TobiasRosini/cnc_plasmacutter/README.md

# CNC-Plasmacutter

Kompakter, rollbarer CNC-Plasmaschneidtisch für die Werkstatt.

- Verfahrbereich Düse: 1100 × 550 mm (Y lang, beidseitig angetriebenes Portal; X kurz)
- Plasmagerät: SPARTUS XPro CUT 70CNC
- Steuerung: LinuxCNC mit QtPlasmaC, Mesa 7i96S
- CAD: FreeCAD

## Struktur

| Ordner | Inhalt |
|---|---|
| `docs/` | Projektstand, Notizen, Datenblätter |
| `cad/` | FreeCAD-Modelle |
| `linuxcnc/` | LinuxCNC-/QtPlasmaC-Konfiguration |
| `elektrik/` | Schaltpläne und Verdrahtung |

Aktueller Stand: [docs/CNC_Plasmatisch_Projektstand_vision_2026-10-19.md](docs/CNC_Plasmatisch_Projektstand_vision_2026-10-19.md)
