TobiasRosini/cnc_plasmacutter/cad/energiekette/README.md

# Energieketten

Beide Ketten: **igus E2/000 Serie 2400.03** (innen 38 × 25, außen 54 × 35, Teilung 46 mm/Glied, im Innenradius aufklappbar), Anschlussteile **igus 2030.12PZ** (Kunststoff, verriegelt, Satz für beide Enden): Platte 7 mm, 55 breit, 40 lang, je 2 Bohrungen Ø6,1 im Abstand 25 quer zur Kette, 10 mm vom äußeren Ende; befestigt mit M5. Radius R bis Kettenmitte (igus: Bauhöhe H = 2R + 35). Länge nach igus S/2 + K (Katalog 5.102).

| | Artikel | Glieder | Länge |
|---|---|---|---|
| Y-Kette | 2400.03.125.0 | 23 | 1058 mm (igus-Formel 1056) |
| X-Kette | 2400.03.075.0 | 14 | 644 mm (igus-Formel 629) |
| Anschlussteile | 2030.12PZ.A1 (vormontiert, Einbaulage A1) | 2 Sätze | |
| Trennstege | 211, jedes 2. Glied | Y 11, X 7 | |

Belegung und Leitungen: `docs/Kabelliste.md`.

## Y-Energiekette (rechts, liegend)

```
python3 cad/live.py cad/energiekette/energiekette.py
```

- R125, 23 Glieder, Festpunkt bei Rahmen-y 825 (105 mm vor der Mitte des Y-Wegs, so dass die längere igus-Kette hinten nicht weiter übersteht), **Schlaufe hinten**, die Kabel verlassen den Festpunkt nach vorn (Schaltschrank und Plasmagerät stehen vorn). Seit die X-Ablage über der Brücke liegt, reicht die Schlaufe nur noch knapp 10 mm hinter den Rahmen.
- Träger Stahl 40 × 20 × 2 flach von hinten bis y 1437 (endet vorn im Kanalknoten), Unterkante 163 mm über Rahmen-OK (über dem X-Schalterblock), darauf hinten eine Rinne aus Alu-U-Profil 20 × 60 × 20 × 2 (Handel, z. B. alu-verkauf.de; innen 56, Kette 54) bis hinter das feste Kettenende, davor ein Kabelkanal 40 × 40 bis y 1437. Träger und Kanal stecken vorn gemeinsam im gedruckten **Kanalknoten** (`cad/unterbau/README.md`), der Träger dort mit 2× M5 von innen in Nietmuttern. Zwei Stützen außen am Längsträger: hinten am Rahmenende ein Rohr 20 × 40 × 2 (2× M6 in Nietmuttern) mit Druckkopf unter dem Träger (kopfüber druckbar, M5-Muttern in Schlitzen); vorn direkt hinter dem vorderen Bein ein Rohr 40 × 40 × 2 (y 1436–1476, 4× M6 in Nietmuttern in Längsträger und Längsrohr des Untertischs) von Rahmen-z 680 bis 900, darauf der Kanalknoten (2× M5 von vorn in Nietmuttern). Außen an der vorderen Stütze ist der senkrechte Kabelkanal befestigt (4× M5 in Nietmuttern).
- Kettenturm aus Alu-Flachmaterial 40 × 8 an der Stirn der rechts um 48,5 mm verlängerten Brücke (Stirn liegt am Turm an): 4× M6 in Muttern eines Einsteckteils (Druck, Muttern seitlich eingeschoben), das in der Brücke steckt und von den beiden M6 des Sattels mit gehalten wird. Ohne Laschen: Druckteile mit eingepressten M5-Muttern sitzen innen am Turm (Halter Y oben, Ablagehalter X unten).
- Kette innen 7 mm außerhalb der Schienenmitte: Der Z-Schlitten fährt bei X ganz rechts bis knapp davor. Der Z-Kopf ist rechts schmaler (52 statt 58 mm).
- Gesamtbreite mit Kette: 781 mm.
- Im Zusammenbau wird die Kette für die jeweilige Portallage neu berechnet.

## X-Energiekette

Seiten von vorn gesehen (vorn = +Y): die Y-Kette liegt rechts (kleines x).

- R75 (R65 gibt es bei igus nicht; die Adern liegen innen in der Kehre damit noch über R60), 14 Glieder, liegend auf einer Ablage (Alu 40 × 20 × 2 + Rinne aus demselben U-Profil 20 × 60 × 20 × 2 wie in Y) über der Brücke, direkt hinter dem Z-Kopf, Unterkante 225 mm über Rahmen-OK, oben bis 432.
- **Festpunkt bei Rahmen-x 476** (2× M5 durch den Rinnenboden: vorn in eine Nietmutter der Ablage, hinten in eine seitlich eingeschobene Mutter im dritten Rinnenhalter, weil die Rinne dort hinten über die Ablage übersteht), **Schlaufe nach rechts** zum Kettenturm. Der Festpunkt liegt so weit rechts, wie es die Kette mit igus-Länge zulässt: Bei X ganz rechts beginnt der Bogen direkt am Anschlussteil, die Schlaufe bleibt 4 mm vor dem Turm. Steht der Wagen links, trägt sich das obere Trum etwa 160 mm frei über den Festpunkt hinaus (igus: freitragend bis etwa 2 m). Bewegtes Ende am Halter (Druck) an der Rückseite des Z-Kopf-Sockels (2× M5 in Muttern), 10 mm rechts der Wagenmitte. Die Leitungen treten dort nach links aus.
- Warum nicht ganz links: kürzere Kette und kürzerer Rücklauf der Leitungen in der Ablage hinten (vorher Festpunkt links, 0,80 m Kette, 1,42 m Leitung bis zum Festpunkt). Ganz in die Mitte geht mit der igus-Länge nicht, dann stieße die Schlaufe an den Turm.
- Warum Schlaufe rechts: Die Adern müssen am bewegten Ende zum Brenner umkehren (Kehre R60, etwa 70 mm). Rechts stehen bei X am Ende Kettenturm und Y-Kettenende; links ist der Platz frei. Bei X ganz links reichen die Adern 4 mm über die Brückenstirn (Rahmen-x 724, oberhalb der Platte, innerhalb der Gesamtbreite).
- Ablage (y −20…20) bündig mit Turm und Platte (Brückentiefe), oben bündig mit der Platte. Die Rinne darauf ist auf die Kette ausgerichtet (Kettenvorderkante y 13,5) und steht hinten 23,5 mm über, vorn 3,5 mm hinter der Ablage. Ablage und Rinne reichen rechts bis an den Ablagehalter (Druck, Platte 15 mm innen am Turm, 2× M5 durch den Turm) und stecken auf dessen Zapfen (25 mm, 2× M5 von unten); bei X ganz rechts liegt die Schlaufe auf Halter und Rinne, links an der Platte an der linken Brückenstirn (Stopfen mit 2× M5). Die Rinne endet hinter dem Festpunkt; links davon liegt nichts mehr auf der Ablage.
- Rinnenhalter (Druck, 3×, L-Profil 20 breit): Platte unter der Ablage (2× M5 von unten in Nietmuttern), dahinter hoch bis unter die Ablage hinten (1× M4 in seitlich eingeschobene Mutter). Zwei bei Rahmen-x 60 und 270, der dritte unter dem festen Kettenende; er schließt links mit der Ablage hinten ab (22 breit), reicht hinter der Ablage bis unter die Rinne und nimmt das hintere M5 des Kettenendes auf. Unten an den kurzen Kanten Fasen 3 mm.

## Leitungen (ohne Schutzschlauch)

Der Mantel des Brennerpakets wird bis zur Knickschutztülle aufgeschnitten; die Adern (PU-Luftschlauch 8, Stromkabel 6,3, Pilot ~3, 2× ~2) laufen lose mit den Motor- und Schalterkabeln durch beide Ketten. Kleinster Biegeradius 60 (Stromkabel). Zwischen den Ketten bleiben die Leitungen in **zwei Pfaden** wie in den Fächern der Ketten (Trennsteg): **Brenner** (17,5 breit) und **Steuerung** (16 breit), beide 13 hoch, 3 mm Abstand. Im Modell als zwei Rechteck-Hüllkörper entlang des Wegs, Ø16 für die Adern zum Brenner.

- **Y-Ende → X-Festpunkt** (ca. 1,32 m): am Y-Ende nach vorn (Kabelbinder im Halter Y), hoch, im Bogen über das Y-Kettenende nach hinten, hinter der Ablage hinunter, auf einer **Ablage hinten** (Alu-Flachstange 40 × 8 auf drei Haltern aus Druck, je 2× M5 von unten in Nietmuttern der Ablage) nach links und mit einer Kehre R60 in den Festpunkt.
- **Lage der Pfade:** In der Y-Kette liegt die Steuerung innen (zur Maschinenmitte), der Brenner außen. So bleiben sie über Leitungsbogen, Versatz und Umlenkkopf nebeneinander (Steuerung links in Laufrichtung). Der Bogen unten am Mast stellt sie übereinander (Steuerung oben); auf den ersten etwa 200 mm der Ablage hinten (bis Rahmen-x 270 ab Schienenmitte) wird das Bündel um 90° verdrillt, danach liegen sie wieder nebeneinander, Steuerung vorn. So liegt die Steuerung innen in der Kehre und am Festpunkt hinten in der X-Kette.
- **Biegeradien:** Der Versatz oben und der Bogen unten am Mast liegen in der Ebene der Pfade, dort läuft ein Pfad innen. Der Versatz hat deshalb R70 auf der Bündelmitte: Der Brennerpfad liegt im Versatz innen bei R59,8 (Stromkabel in der Mitte des Brennerfachs). Unten am Mast und in der Kehre liegt die Steuerung innen (R50,5, Motorleitung braucht 38), der Brenner außen (R70). Leitungsbogen und Umlenkkopf biegen quer zu den Pfaden (R60).
- **X-Ende → Brenner** (ca. 0,40 m): nach links aus dem Kettenende, hoch, im Bogen nach vorn und von oben in die Tülle. Höchster Punkt bei Z unten ca. 1,47 m über Boden; bei Z oben wird die Schlaufe 100 mm länger und wölbt sich etwas höher.
- Motor- und Schalterkabel zweigen am X-Ende ab.
- **Führungen (Druck):** Am bewegten Y-Ende sitzt auf dem Halter Y der **Leitungsbogen**: Die Leitungen laufen innen um ihn (R60) von der Kette nach vorn, hoch und zurück; Wangen links und rechts, Kabelbinder durch zwei Schlitze. Befestigt mit den beiden M5 des Kettenendes (länger, etwa M5 × 75, von unten durch Anschlussteil, Halter und Bogen, Muttern seitlich eingeschoben). Dahinter versetzen sich die Leitungen frei etwa 50 mm zur Seite (R70) (neben die Y-Kette) und laufen über den **Umlenkkopf** (Druck, R60, aus einem Stück, auf der Wange liegend stützenfrei druckbar) senkrecht hinunter in die Ablage hinten. Der Umlenkkopf sitzt auf einem **Mast** (Alu-Flachstange 40 × 8 wie der Kettenturm, unten 2× M4 in Gewinde in der hinteren Stirn der Ablage hinten, Kopf mit 2× M4 in Muttern; versteift mit einem **Versteifungswinkel** (Druck, 38 × 94 × 106) außen an der Ecke: Schenkel hinter dem Mast, Bodenplatte unter Mast und Ablage, zwei Rippen nach hinten, je 2× M4 in Gewinde in Ablagestirn, Mast und Ablage von unten; vor dem Mast laufen die Leitungen im Bogen, dort ist kein Platz), zur Kettenseite offen zum Einlegen, ohne Trennsteg. Am senkrechten Lauf hält eine **Spezialschelle** die Pfade an der Rückwand (bei z 495): rechts verschraubt wie die anderen (M3 in die Rückwand), links endet das Dach vor der Wange, die dort die Tunnelwand ist, und greift mit einem Nippel (4 tief, 2 dick, 11 lang) in eine Vertiefung der Wange (oben 0,2 Luft, unten 1,5 zum Einhängen): schräg einhängen, rechts herunterklappen, festschrauben; dafür ist die Rückwand oberhalb der Y-Kette (ab z 478, 8 mm über deren Oberkante) nach rechts verbreitert. Darunter ein Kabelbinder durch die Rückwand. Unter den Leitungen trägt nur ein 12-mm-Steg (im Bogen und oben, unter der Verbindungsplatte unterhalb ihrer Aussparung), daneben bleibt nur die Wange; unten vorn ist der Kopf mit einer Viertelellipse ausgeschnitten (vorn bis 2 mm unter den Steg, unten 10 mm vor den Leitungen); die M4-Muttern der Verbindungsplatte sind von unten in den Steg eingepresst; oben endet er mit dem Mast bündig bei z 591,5. Zwischen Kopf und dem Bogen unten liegen die Leitungen auf einem **Distanzstück** (Druck, 44 × 13,5 × 80, z 350–430, rechts nicht breiter als die Leitungen wegen der Y-Kette): 2× M4 von hinten durch den Mast in seitlich eingeschobene Muttern, zwei Kabelbinder quer durch Kanäle im Distanzstück um das Bündel. Eine Schelle passt dort nicht, ihr rechter Schenkel läge in der Y-Kette. Bogen und Kopf sind oben mit einer **Verbindungsplatte** (Druck, 15 dick, im Grundriss dem Leitungsverlauf folgend: Band in Schellenbreite + 1 mm, in den Aussparungen voll) verbunden: Sie liegt in Aussparungen beider Teile, je 2× M4 (Zylinderkopf versenkt) in seitlich eingeschobene Muttern; die Leitungen liegen auch zwischen Bogen und Kopf auf ihr auf. Der Bogen hat in der Biegung einen **Trennsteg** (3 breit, 8 hoch) zwischen den Pfaden und ist **dreiteilig** (`_a`, `_steg`, `_b`): zwei Hälften mit je einer ganzen Seitenplatte (außen bündig mit der Schellenauflage), auf dieser liegend gedruckt, und der Trennsteg als flache Scheibe (3 mm) dazwischen; zusammengehalten von 2× M3 × 55 quer (Zylinderkopf gesenkt, Mutter außen in Tasche). Am Steg angesetzt stünde er auf der Hälfte 8 mm frei über dem Leitungskanal. Festgehalten werden die Pfade mit fünf gleichen **Leitungsschellen** (Druck, 15 lang, 57,3 breit, 17 hoch, senkrechte Kanten gerundet: außen R3, Schenkel innen R2, Mittelsteg R0,9): zwei Tunnel (Brenner 18,5, Steuerung 17, je 14 hoch) mit 2 mm Mittelsteg, je 1× M3 × 25 durch die beiden Schenkel in Muttern 8 mm unter der Auflage (seitlich eingeschoben, in der Verbindungsplatte von unten eingepresst). Oben auf Bogen, Verbindungsplatte und Kopf (Bogen und Kopf mit Auflage für die Schelle), am Kopf am senkrechten Lauf die Spezialschelle (s. o.), in der Ablage hinten zweimal auf einem **Leitungssockel** (Druck, 32 lang, 14,6 hoch): Er hebt die Pfade auf die Höhe der X-Kette und ist mit 2× M3 von unten durch die Flachstange in eingepressten Muttern befestigt.
- Kabelkanal auf dem Y-Träger: 3× M4 durch den Kanalboden in Nietmuttern M4 im Träger (y 950 / 1150 / 1350).
- Gesamtbreite: 784 mm.
