TobiasRosini/cnc_plasmacutter/cad/y_antrieb/README.md

# Y-Antrieb

```
python3 cad/live.py cad/y_antrieb/y_antrieb.py
```

- Motoren NEMA23 3 Nm (112 mm) hinten am Schienenanfang, **innen**, Achse quer. Riemenscheibe 24 Z genau über der Schienenmitte, Achse 65,8 mm über Rahmenoberkante und 32 mm hinter dem Schienenende (der Winkel fährt bis ans Schienenende).
- Umlenkrollen vorn gleich, auf M8-Achse (Mutter innen versenkt).
- Halter (3D-Druck) auf dem Längsträger: Basis 10 mm mit 4× M6 (Gewinde oder Nietmuttern im Rohr), senkrechte Platte 10 mm, Rippe hinten. Motor mit 4× M5, Muttern in Taschen außen.
- Die linken Teile sind gespiegelt (`*_l`), vorn werden sie um 180° gedreht eingesetzt.
- Der Rahmen hat hinter dem Schienenanfang 70 mm Platz für die Motoren (siehe Grundrahmen, Längsaufteilung).
- Kabelaustritt der Motoren nach hinten.
