TobiasRosini/cnc_plasmacutter/linuxcnc/README.md

# LinuxCNC

Konfiguration für LinuxCNC mit QtPlasmaC und Mesa 7i96S (Ethernet).
