TobiasRosini/cnc_plasmacutter/cad/VERBINDUNGEN.md

# Schraubverbindungen (Stand 24.10.2026)

Vorgabe: am Rahmen keine langen Bolzen mit Mutter, sondern Gewinde (direkt geschnitten oder Nietmutter / Einpressmutter im Rohr). In Druckteilen bevorzugt eingepresste Muttern, sonst eingeschmolzene Gewindeeinsätze.
Geprüft mit `python3 cad/live.py cad/pruefe_montage.py`. Die Prüfung meldet jetzt auch Bohrungen, die sich im selben Teil schneiden.

## Rahmen

| Verbindung | Ausführung | Stand |
|---|---|---|
| Oberrahmen auf Untertisch | 6× M8×16 durch die Unterseite des oberen Querrohrs (Zugang Ø16 von oben) in Nietmuttern M8 im unteren Querrohr | **neu** (vorher M8×90 mit Mutter) |
| Wannenkäfig am Untertisch | 6× M6 durch die Außenwand des Rings (innen Zugang Ø12, Wanne vorher heraus) in Nietmuttern M6 im Längsrohr | **neu** (vorher M8 quer mit Mutter, Bohrungen lagen 10 mm versetzt) |
| Y-Schienen | M4 direkt in die 3-mm-Wand geschnitten | ok |
| Y-Motor- und Umlenkhalter (Druck) | 4× M6 in Nietmuttern, Köpfe gesenkt | ok |
| Y-Kettenstützen | hinten Rohr 20×40×2 (2× M6), vorn Rohr 40×40×2 (4× M6, Längsträger und Längsrohr Untertisch), durch die Innenwand (außen Zugang Ø13) in Nietmuttern M6 | **neu** (vorn 40×40 hinter dem Bein, trägt den senkrechten Kanal) |
| Stützkopf hinten (Druck) im Rohr | 2× M5 durch die Rohrwand in Muttern, die von unten in Schlitze im Zapfen geschoben werden | **neu** |
| Y-Kettenträger auf Stützkopf hinten | 2× M6 von unten in Nietmuttern in der Trägerunterseite | **neu** |
| Kanalknoten (Druck) auf vorderer Stütze | 2× M5 von vorn durch die Schürze in Nietmuttern in der Vorderwand der Stütze | **neu** (ersetzt den vorderen Stützkopf) |
| Y-Kettenträger im Kanalknoten | 2× M5 von innen durch die Knotenwand in Nietmuttern in der Innenseite des Trägers | **neu** |
| Rinnen auf den Trägern | Blindnieten Ø4 | offen (Lage beim Bau) |
| Geräteboden (Siebdruck 9) auf untere Längsrohre | 6× M6 von oben in Nietmuttern M6 | **neu** |
| Spritzschutz Y an Längsträgern | je 6 Blindnieten Ø4 | **neu** |
| Halter Spritzschutz X an Flachstange | 2× M4 in Gewinde in der vorderen Stirn | **neu** |
| Schutzstreifen X an Halter | 2× M4 mit Mutter je Seite | **neu** |
| Kabelkanal auf Y-Träger | 3× M4 in Nietmuttern M4 | **neu** |
| Kabelkanäle senkrecht / quer | je 2× M5 aus dem Kanal in Nietmuttern M5: senkrecht auf der vorderen Kettenstütze (2 Höhen), quer im vorderen Bein | **neu** (ohne Distanzstücke) |
| Tropfboden | | offen |
| Stellfüße / Rollen | Fußplatte 8 mm mit Ø13 | offen: M12 schneiden (nur gut 4 Gänge) oder Mutter aufschweißen |

## Portal und Wagen

| Verbindung | Ausführung | Stand |
|---|---|---|
| Flachstange auf Y-Wagen | 4× M4 von oben, gesenkt | ok |
| Y-Winkel (Druck) auf Flachstange | M4 gesenkt in Gewinde in der Flachstange, Riemenklemme M5×65 durch Turm und Basis in Gewinde | ok (lange Schraube, aber in Gewinde) |
| Sattel ↔ Brücke | 4× M6×60 quer durch Sattel, Brücke und Einsteckteil, Muttern vorn eingepresst, Köpfe hinten | bleibt. Zugang geprüft: Muttern sind gefangen, die unteren Köpfe immer frei, die oberen liegen unter Y-Klemmplatte und Fahne → Brücke vor der Riemenklemme montieren |
| Kettenturm / linke Platte an Einsteckteil | 4× M6 in Muttern, seitlich in Schlitze geschoben | links Löcher verlegt (schnitten die Sattel-M6) |
| X-Schienen an Brücke | M4 in die 4-mm-Alu-Wand | ok |
| X-Wagenkörper auf X-Wagen | 4× + 4× M4, gesenkt mit Scheibe | ok |
| Z-Grundplatte an Wagenkörper | 6× M5 in Muttern, von der Seite eingeschoben | ok |
| Motorbock an Wagenkörper | 4× M4 in Muttern, von der Seite eingeschoben | ok |
| Motor X | 4× M5 in Langnuten (Muttern) | ok |
| Umlenkrollen X | M8 von unten, Kopf in Sechskanttasche, oben Mutter | ok |
| Spritzschutz | 4× M3×6 in Muttern, von der Seite eingeschoben | ok |

## Muttern in Druckteilen

Keine Gewindeeinsätze mehr. Wo die Schraube die Mutter in eine Tasche an der Außenfläche zieht, ist es eine einfache Sechskanttasche; sonst ein Schlitz, durch den die Mutter seitlich eingeschoben wird (Schlüsselflächen parallel zum Schlitz, dreht nicht mit). Taschenmaße: M3 5,7 × 2,7, M4 7,2 × 3,5, M5 8,2 × 4,3, M6 10,2 × 5,3 (`fc_dok.mutter`).

| Teil | Muttern |
|---|---|
| y_portalwinkel (beide) | 4× M3 innen an der Sattelrückwand (X-Riemenklemme) |
| x_wagenkoerper | 4× M4 (Motorbock), 6× M5 (Z-Grundplatte), 4× M3 (Spritzschutz), alle seitlich |
| z_kopf | 8× M4 unten (FK10, Motorhalter), 2× M5 von unten in Schlitze (Halter X-Kette) |
| z_mutterblock | 4× M4 hinten |
| z_halter_oben | 1× M12 eingepresst (Schalter Schwimmkopf); 2× M5 von oben in Gewinde im Schlitten |
| z_traeger | Kegelschmiernippel M6 in Gewinde, im Druck geschnitten |
| ek_einsteckteil rechts/links | je 4× M6 seitlich |
| ek_halter_y | 2× M5 oben (Kettenende), 2× M5 von oben in Schlitze (Turm) |
| ekx_ablagehalter | 2× M5 von unten (Turm), 2× M5 seitlich im Zapfen |
| ekx_rinnenhalter | je 2× M5 von unten in Nietmuttern der Ablage, 1× M4 seitlich (Ablage hinten); der dritte zusätzlich 1× M5 seitlich (hinteres M5 des festen X-Kettenendes) |
| ek_leitungsbogen (a, steg, b) | 2× M5 (Kettenende) von unten, 2× M4 Verbindungsplatte, Muttern seitlich; 2× M3 × 55 quer durch alle drei Teile, Mutter außen in Tasche |
| ekx_umlenkkopf | 2× M4 vom Mast (Muttern seitlich), 2× M4 Verbindungsplatte (Muttern von unten eingepresst); Leitungsschelle oben; am senkrechten Lauf Spezialschelle: rechts 1× M3, links Nippel in Vertiefung der Wange |
| ekx_mastwinkel | 2× M4 × 25 durch Winkel und Mast in Gewinde in der Ablagestirn (ersetzt die kurzen Mastschrauben), 2× M4 in Gewinde im Mast, 2× M4 von unten in Gewinde in der Ablage |
| ekx_distanzstueck | 2× M4 × 20 von hinten durch den Mast, Muttern von links eingeschoben; 2 Kabelbinder quer |
| ek_verbindungsplatte | je 2× M4 von oben in Bogen und Kopf, 2× M3 Leitungsschelle (Muttern von unten) |
| ek_leitungsschelle | 2× M3 × 25 durch die Schenkel in Muttern der Unterlage (Bogen, Kopf oben, Sockel seitlich eingeschoben; Platte von unten) |
| ekx_schelle_einseitig | 1× M3 × 25 rechts durch den Schenkel in Mutter in der Rückwand des Umlenkkopfs (seitlich eingeschoben), links Nippel in Vertiefung der Wange |
| ekx_leitungssockel | 2× M3 von unten durch die Ablage hinten in eingepresste Muttern |
| ekx_halter | 2× M5 oben (Kettenende) |
| ub_uebergang_unten | 2× M3 für den Deckel, seitlich eingeschoben |
| ekx_stopfen | 2× M5 seitlich |
| ek_stuetzen_kopf | je 2× M5 von unten |
