TobiasRosini/cnc_plasmacutter/cad/stueckliste.md

# Stückliste

Erzeugt von `cad/teilenummern.py` aus dem Zusammenbau (nicht von Hand ändern). Gleiche Teile haben die gleiche Nummer, Spiegelteile eine eigene. Nummern stehen fest in `cad/teilenummern.json`; neue Teile bekommen die nächste freie Nummer. Im Zusammenbau steht die Nummer vorn in der Beschriftung. Leitungen (Hüllrohre) sind keine Teile. Schrauben, Muttern, Nietmuttern noch nicht enthalten.

| Nr. | Teil | Stk. | Art | Maße (mm) | Baugruppe | Datei | Bemerkung |
|---:|---|---:|---|---|---|---|---|
| 001 | UT_Bein | 3 | Stahl | 802 × 40 × 40 | Untertisch |  |  |
| 002 | UT_Fussplatte | 4 | Stahl | 100 × 100 × 8 | Untertisch |  |  |
| 003 | UT_Bein_3 | 1 | Stahl | 802 × 40 × 40 | Untertisch |  |  |
| 004 | UT_Laengsrohr_oben_L | 1 | Stahl | 1436 × 40 × 40 | Untertisch |  |  |
| 005 | UT_Laengsrohr_unten | 2 | Stahl | 1436 × 40 × 40 | Untertisch |  |  |
| 006 | UT_Laengsrohr_oben_R | 1 | Stahl | 1436 × 40 × 40 | Untertisch |  |  |
| 007 | UT_Querrohr_oben | 2 | Stahl | 640 × 40 × 40 | Untertisch |  |  |
| 008 | UT_Querrohr_unten | 4 | Stahl | 640 × 40 × 40 | Untertisch |  |  |
| 009 | wannenkaefig | 1 | Stahl | 1235 × 640 × 100 | Untertisch | wannenkaefig/wannenkaefig.step |  |
| 010 | Ablauf | 1 | Kaufteil | 120 × 32 × 32 | Untertisch |  |  |
| 011 | Wanne | 1 | Stahl (Wanne) | 1194 × 597 × 119 | Untertisch |  |  |
| 012 | kammtraeger | 3 | Stahl | 1080 × 87 × 3 | Untertisch | auflage/kammtraeger.step |  |
| 013 | auflageleiste | 22 | Stahl | 530 × 50 × 3 | Untertisch | auflage/auflageleiste.step |  |
| 014 | Schiene_HGR15_1300 | 2 | Kaufteil | 1300 × 15 × 15 | Oberrahmen |  |  |
| 015 | OR_Laengstraeger_L | 1 | Stahl | 1556 × 40 × 40 | Oberrahmen |  |  |
| 016 | OR_Laengstraeger_R | 1 | Stahl | 1556 × 40 × 40 | Oberrahmen |  |  |
| 017 | OR_Quertraeger_V | 1 | Stahl | 640 × 40 × 40 | Oberrahmen |  |  |
| 018 | OR_Quertraeger_H | 1 | Stahl | 640 × 80 × 40 | Oberrahmen |  |  |
| 019 | OR_Spritzschutz | 2 | Stahl | 1280 × 50 × 3 | Oberrahmen |  |  |
| 020 | flachstange_40x15 | 2 | Alu | 180 × 40 × 15 | Portal | y_portalwinkel/flachstange_40x15.step |  |
| 021 | spannschlitten | 2 | Druck | 43 × 24 × 7 | Portal | y_portalwinkel/spannschlitten.step |  |
| 022 | klemmplatte_fest | 2 | Druck | 48 × 40 × 6 | Portal | y_portalwinkel/klemmplatte_fest.step |  |
| 023 | klemmplatte_schlitten | 2 | Druck | 35 × 28 × 17 | Portal | y_portalwinkel/klemmplatte_schlitten.step |  |
| 024 | Wagen_HGH15CA | 8 | Kaufteil | 61 × 34 × 24 | Portal, X-Achse, Z-Achse |  |  |
| 025 | winkel_fest | 1 | Druck | 180 × 94 × 52 | Portal | y_portalwinkel/winkel_fest.step |  |
| 026 | x_klemmplatte | 2 | Druck | 40 × 36 × 6 | Portal | y_portalwinkel/x_klemmplatte.step |  |
| 027 | y_ref_fahne | 1 | Stahl | 46 × 32 × 15 | Portal |  | Spiegelteil zu 029 |
| 028 | winkel_kasten | 1 | Druck | 180 × 118 × 52 | Portal | y_portalwinkel/winkel_kasten.step |  |
| 029 | y_ref_fahne_rechts | 1 | Stahl | 46 × 32 × 15 | Portal |  | Spiegelteil zu 027 |
| 030 | Naeherungsschalter_LJ12A3 | 5 | Kaufteil | 70 × 20 × 17 | Portal, Z-Achse, Y-Antrieb |  |  |
| 031 | Portalbruecke_80x40x4 | 1 | Alu | 769 × 80 × 40 | Portal |  |  |
| 032 | x_schutz_halter | 2 | Alu | 65 × 33 × 4 | Portal |  |  |
| 033 | x_schutzstreifen | 1 | Stahl | 620 × 50 × 3 | Portal |  |  |
| 034 | Schiene_HGR15_640 | 2 | Kaufteil | 640 × 15 × 15 | X-Achse |  |  |
| 035 | x_wagenkoerper | 1 | Druck | 172 × 69 × 60 | X-Achse | x_wagen/x_wagenkoerper.step |  |
| 036 | x_spritzschutz | 1 | Stahl | 69 × 60 × 1 | X-Achse | x_wagen/x_spritzschutz.step |  |
| 037 | x_motorbock | 1 | Druck | 94 × 90 × 84 | X-Achse | x_wagen/x_motorbock.step |  |
| 038 | Riemenscheibe_HTD5M | 3 | Kaufteil | 44 × 44 × 27 | X-Achse, Y-Antrieb |  |  |
| 039 | Umlenkrolle_22 | 2 | Kaufteil | 22 × 22 × 17 | X-Achse |  |  |
| 040 | Motor_NEMA23_88 | 2 | Kaufteil | 88 × 79 × 56 | X-Achse, Z-Achse |  |  |
| 041 | x_ref_stift | 1 | Stahl | 10 × 6 × 6 | X-Achse | x_wagen/x_ref_stift.step |  |
| 042 | Riemen_HTD5M_15_294 | 2 | Kaufteil (Riemen) | 294 × 15 × 4 | X-Achse |  |  |
| 043 | z_grundplatte | 1 | Alu | 308 × 104 × 12 | Z-Achse | z_achse/z_grundplatte.step |  |
| 044 | z_leisten_20x20 | 2 | Alu | 220 × 20 × 20 | Z-Achse | z_achse/z_leisten_20x20.step |  |
| 045 | z_schlitten | 1 | Alu | 120 × 100 × 12 | Z-Achse | z_achse/z_schlitten.step |  |
| 046 | z_mutterblock | 1 | Druck | 54 × 46 × 40 | Z-Achse | z_achse/z_mutterblock.step |  |
| 047 | z_kopf | 1 | Druck | 110 × 78 × 20 | Z-Achse | z_achse/z_kopf.step |  |
| 048 | z_halter | 1 | Druck | 90 × 78 × 51 | Z-Achse | z_achse/z_halter.step |  |
| 049 | z_traeger | 1 | Druck | 92 × 70 × 22 | Z-Achse | z_achse/z_traeger.step |  |
| 050 | Schiene_HGR15_220 | 2 | Kaufteil | 220 × 15 × 15 | Z-Achse |  |  |
| 051 | Mutter_SFU1204 | 1 | Kaufteil | 42 × 42 × 35 | Z-Achse |  |  |
| 052 | Spindel_SFU1204 | 1 | Kaufteil | 278 × 12 × 12 | Z-Achse |  |  |
| 053 | Festlager_FK10 | 1 | Kaufteil | 42 × 42 × 27 | Z-Achse |  |  |
| 054 | Kupplung | 1 | Kaufteil | 30 × 25 × 25 | Z-Achse |  |  |
| 055 | Stäbe_D8 | 2 | Kaufteil | 100 × 8 × 8 | Z-Achse |  |  |
| 056 | Brenner_SP80M | 1 | Kaufteil | 540 × 42 × 36 | Z-Achse |  |  |
| 057 | z_ref_fahne | 1 | Stahl | 24 × 20 × 3 | Z-Achse | z_achse/z_ref_fahne.step |  |
| 058 | z_motorhalter | 1 | Druck | 84 × 64 × 53 | Z-Achse | z_achse/z_motorhalter.step |  |
| 059 | z_klemmdeckel | 1 | Druck | 70 × 60 × 22 | Z-Achse | z_achse/z_klemmdeckel.step |  |
| 060 | z_halter_oben | 1 | Druck | 78 × 72 × 15 | Z-Achse | z_achse/z_halter_oben.step |  |
| 061 | Zielstift_6x10 | 1 | Kaufteil | 10 × 6 × 6 | Z-Achse |  |  |
| 062 | Schmiernippel_M6 | 2 | Kaufteil | 13 × 8 × 7 | Z-Achse |  |  |
| 063 | y_motorhalter | 1 | Druck | 108 × 64 × 49 | Y-Antrieb | y_antrieb/y_motorhalter.step | Spiegelteil zu 065 |
| 064 | Motor_NEMA23_99 | 2 | Kaufteil | 99 × 88 × 56 | Y-Antrieb |  |  |
| 065 | y_motorhalter_l | 1 | Druck | 108 × 64 × 49 | Y-Antrieb | y_antrieb/y_motorhalter_l.step | Spiegelteil zu 063 |
| 066 | y_umlenkhalter | 1 | Druck | 97 × 64 × 49 | Y-Antrieb | y_antrieb/y_umlenkhalter.step | Spiegelteil zu 068 |
| 067 | Umlenkrolle_44 | 2 | Kaufteil | 44 × 44 × 19 | Y-Antrieb |  |  |
| 068 | y_umlenkhalter_l | 1 | Druck | 97 × 64 × 49 | Y-Antrieb | y_antrieb/y_umlenkhalter_l.step | Spiegelteil zu 066 |
| 069 | Riemen_HTD5M_15_650 | 2 | Kaufteil (Riemen) | 650 × 15 × 4 | Y-Antrieb |  |  |
| 070 | Riemen_HTD5M_15_534 | 2 | Kaufteil (Riemen) | 534 × 15 × 4 | Y-Antrieb |  |  |
| 071 | Riemen_HTD5M_15_1364 | 2 | Kaufteil (Riemen) | 1364 × 15 × 4 | Y-Antrieb |  |  |
| 072 | ek_traeger_40x20 | 1 | Stahl | 1445 × 40 × 20 | Energieketten |  |  |
| 073 | ek_rinne | 1 | Alu | 863 × 60 × 20 | Energieketten | energiekette/ek_rinne.step |  |
| 074 | ek_stuetzen_188 | 1 | Stahl | 188 × 40 × 20 | Energieketten |  |  |
| 075 | ek_stuetzen_220 | 1 | Stahl | 220 × 40 × 40 | Energieketten |  |  |
| 076 | ek_stuetzen_kopf | 1 | Druck | 60 × 40 × 40 | Energieketten | energiekette/ek_stuetzen_kopf.step |  |
| 077 | ek_ausleger | 1 | Alu | 433 × 40 × 8 | Energieketten | energiekette/ek_ausleger.step |  |
| 078 | ek_einsteckteil | 1 | Druck | 107 × 72 × 32 | Energieketten | energiekette/ek_einsteckteil.step |  |
| 079 | ekx_traeger_40x20 | 1 | Alu | 754 × 40 × 20 | Energieketten |  |  |
| 080 | ekx_rinne | 1 | Alu | 530 × 60 × 20 | Energieketten |  |  |
| 081 | ekx_stuetze_links | 1 | Alu | 188 × 40 × 8 | Energieketten |  |  |
| 082 | ekx_stopfen | 1 | Druck | 36 × 25 × 16 | Energieketten | energiekette/ekx_stopfen.step |  |
| 083 | ek_einsteckteil_links | 1 | Druck | 72 × 58 × 32 | Energieketten | energiekette/ek_einsteckteil_links.step |  |
| 084 | ek_halter_y | 1 | Druck | 67 × 52 × 20 | Energieketten | energiekette/ek_halter_y.step |  |
| 085 | ekx_ablagehalter | 1 | Druck | 64 × 40 × 22 | Energieketten | energiekette/ekx_ablagehalter.step |  |
| 086 | ekx_rinne_hinten | 1 | Alu | 477 × 40 × 8 | Energieketten | energiekette/ekx_rinne_hinten.step |  |
| 087 | ekx_rinnenhalter_1 | 2 | Druck | 183 × 20 × 18 | Energieketten | energiekette/ekx_rinnenhalter.step |  |
| 088 | ekx_rinnenhalter_2 | 1 | Druck | 183 × 28 × 22 | Energieketten | energiekette/ekx_rinnenhalter.step |  |
| 089 | ekx_halter | 1 | Druck | 119 × 75 × 44 | Energieketten | energiekette/ekx_halter.step |  |
| 090 | Kette_igus_2400_03_R75 | 1 | Kaufteil | 400 × 186 × 55 | Energieketten |  |  |
| 091 | Kette_igus_2400_03_R125 | 1 | Kaufteil | 539 × 285 × 55 | Energieketten |  |  |
| 092 | ek_kabelkanal | 1 | Kaufteil | 582 × 40 × 40 | Energieketten |  |  |
| 093 | ek_leitungsbogen_a | 1 | Druck | 157 × 121 × 28 | Energieketten | energiekette/ek_leitungsbogen_a.step |  |
| 094 | ek_leitungsbogen_steg | 1 | Druck | 130 × 107 × 3 | Energieketten | energiekette/ek_leitungsbogen_steg.step |  |
| 095 | ek_leitungsbogen_b | 1 | Druck | 157 × 121 × 29 | Energieketten | energiekette/ek_leitungsbogen_b.step |  |
| 096 | ekx_mast | 1 | Alu | 356 × 40 × 8 | Energieketten | energiekette/ekx_mast.step |  |
| 101 | ek_verbindungsplatte | 1 | Druck | 90 × 60 × 15 | Energieketten | energiekette/ek_verbindungsplatte.step |  |
| 102 | ek_leitungsschelle | 5 | Druck | 57 × 17 × 15 | Energieketten | energiekette/ek_leitungsschelle.step |  |
| 103 | ekx_leitungssockel | 2 | Druck | 57 × 32 × 15 | Energieketten | energiekette/ekx_leitungssockel.step |  |
| 104 | ub_geraeteboden | 1 | Kaufteil | 1031 × 720 × 9 | Unterbau |  |  |
| 105 | ub_tropfboden | 1 | Alu | 1498 × 640 × 32 | Unterbau | unterbau/ub_tropfboden.step |  |
| 106 | Plasmageraet_XPro_CUT_70CNC | 1 | Kaufteil | 515 × 370 × 215 | Unterbau |  |  |
| 107 | Druckluft_Einheit | 1 | Kaufteil | 180 × 80 × 60 | Unterbau |  |  |
| 108 | Schaltschrank_400x500x200 | 1 | Kaufteil | 500 × 400 × 200 | Unterbau |  |  |
| 109 | ub_kabelkanal_senkrecht | 1 | Kaufteil | 250 × 60 × 25 | Unterbau |  |  |
| 110 | ub_kabelkanal_quer | 1 | Kaufteil | 305 × 60 × 25 | Unterbau |  |  |
| 111 | ub_uebergang_unten | 1 | Druck | 64 × 54 × 54 | Unterbau | unterbau/ub_uebergang_unten.step |  |
| 112 | ub_uebergang_unten_deckel | 1 | Druck | 54 × 54 × 3 | Unterbau | unterbau/ub_uebergang_unten_deckel.step |  |
| 113 | ub_kanalknoten | 1 | Druck | 206 × 78 × 67 | Unterbau | unterbau/ub_kanalknoten.step |  |
| 114 | ekx_umlenkkopf | 1 | Druck | 152 × 117 × 60 | Energieketten | energiekette/ekx_umlenkkopf.step |  |
| 115 | ekx_distanzstueck | 1 | Druck | 80 × 44 × 14 | Energieketten | energiekette/ekx_distanzstueck.step |  |
| 116 | ekx_mastwinkel | 1 | Druck | 106 × 94 × 38 | Energieketten | energiekette/ekx_mastwinkel.step |  |
| 117 | ekx_schelle_einseitig | 1 | Druck | 53 × 17 × 15 | Energieketten | energiekette/ekx_schelle_einseitig.step |  |

113 verschiedene Teile, 186 Stück.
