TobiasRosini/cnc_plasmacutter/cad/auflage/auflage.FCStd

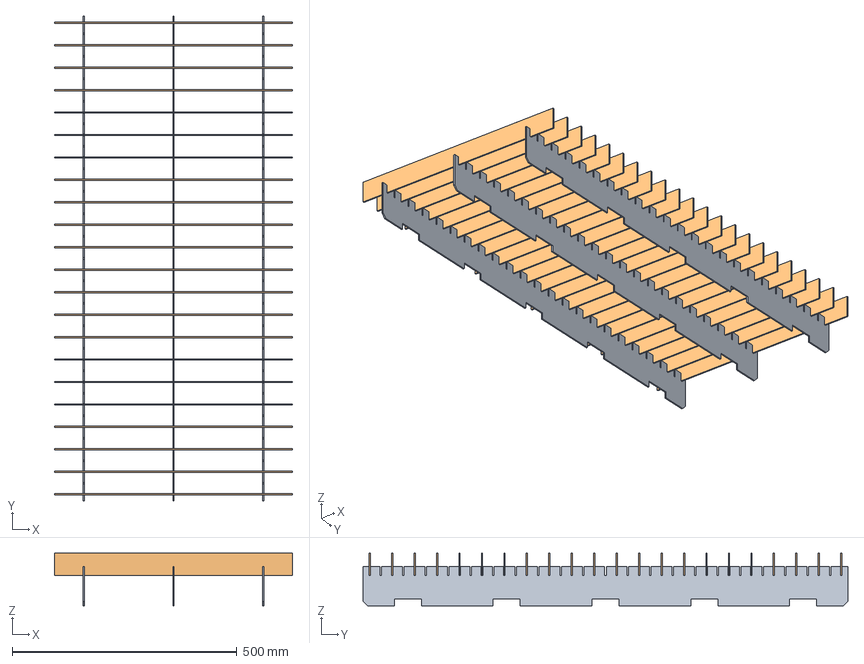
[picture p1: CAD file, 2026-11-04]
cad/auflage/auflage.FCStd
530.0 x 1080.0 x 117.0 mm
Kammtraeger
Auflageleisten
