TobiasRosini/cnc_plasmacutter/cad/energiekette/ekx_schelle_einseitig.step

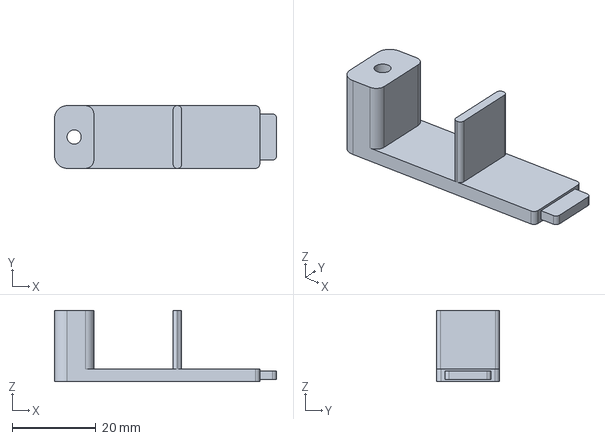
[picture p2: CAD file, 2026-11-12]
cad/energiekette/ekx_schelle_einseitig.step
53.1 x 15.0 x 17.0 mm
