TobiasRosini/cnc_plasmacutter/cad/grundrahmen/grundrahmen.step

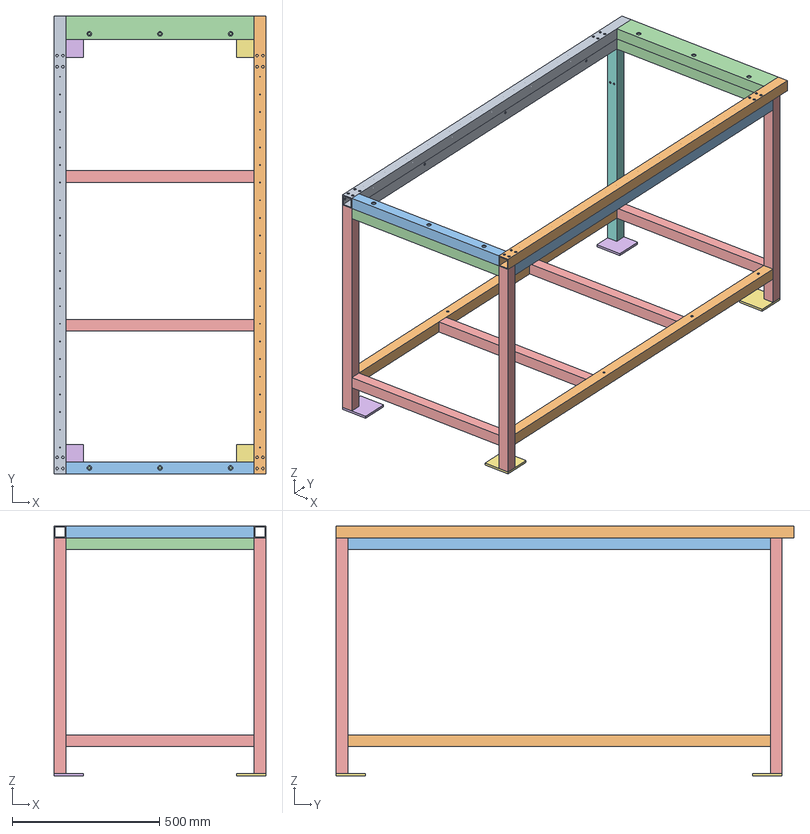
[picture p3: CAD file, 2026-11-09]
cad/grundrahmen/grundrahmen.step
720.0 x 1556.0 x 850.0 mm
