TobiasRosini/cnc_plasmacutter/cad/unterbau/ub_tropfboden.step

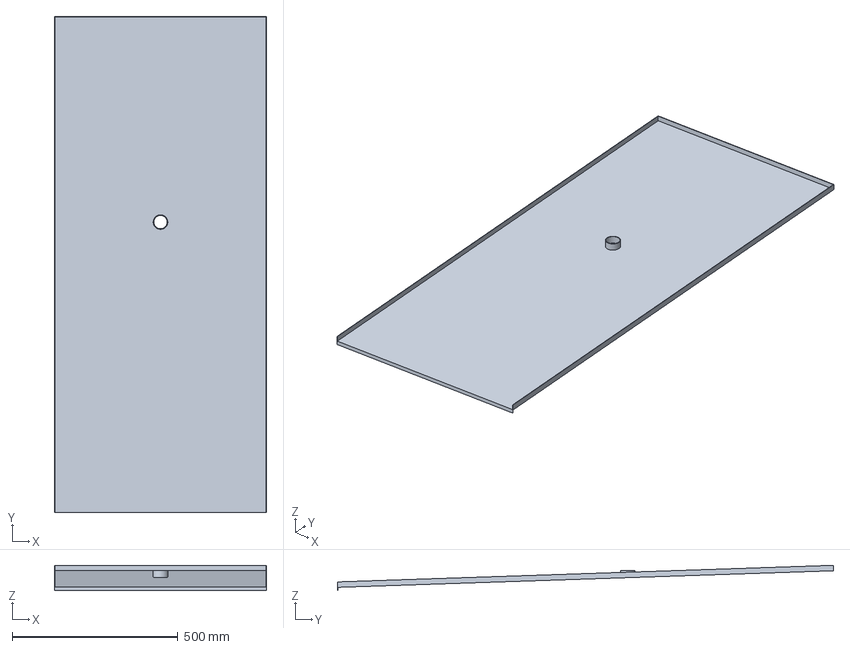
[picture p4: CAD file, 2026-11-09]
cad/unterbau/ub_tropfboden.step
640.0 x 1496.0 x 76.5 mm
