TobiasRosini/cnc_plasmacutter/cad/wanne/wanne.step

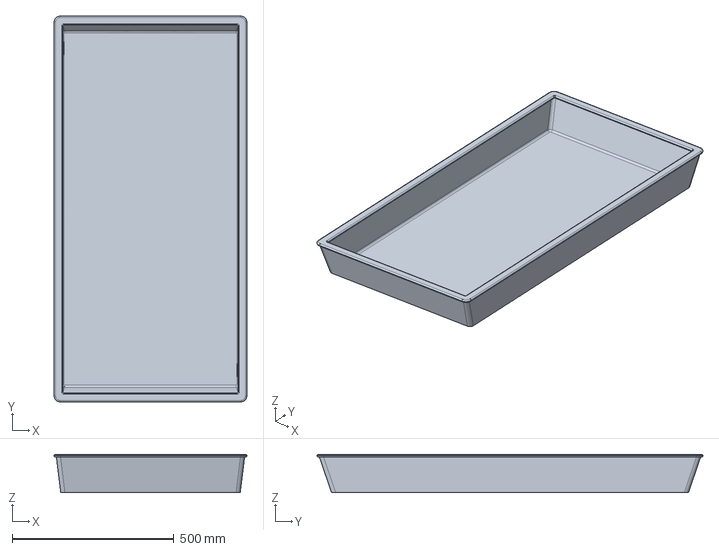
[picture p5: CAD file, 2026-10-24]
cad/wanne/wanne.step
597.0 x 1194.0 x 119.0 mm
