TobiasRosini/cnc_plasmacutter/cad/wannenkaefig/wannenkaefig.step

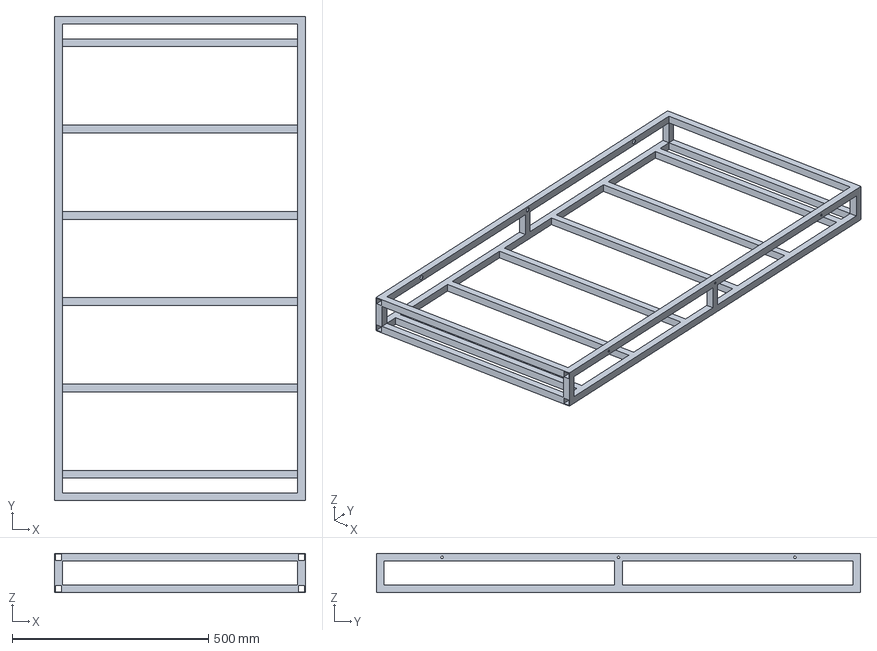
[picture p6: CAD file, 2026-10-24]
cad/wannenkaefig/wannenkaefig.step
640.0 x 1235.2 x 100.0 mm
