TobiasRosini/cnc_plasmacutter/cad/x_wagen/x_wagenkoerper.step

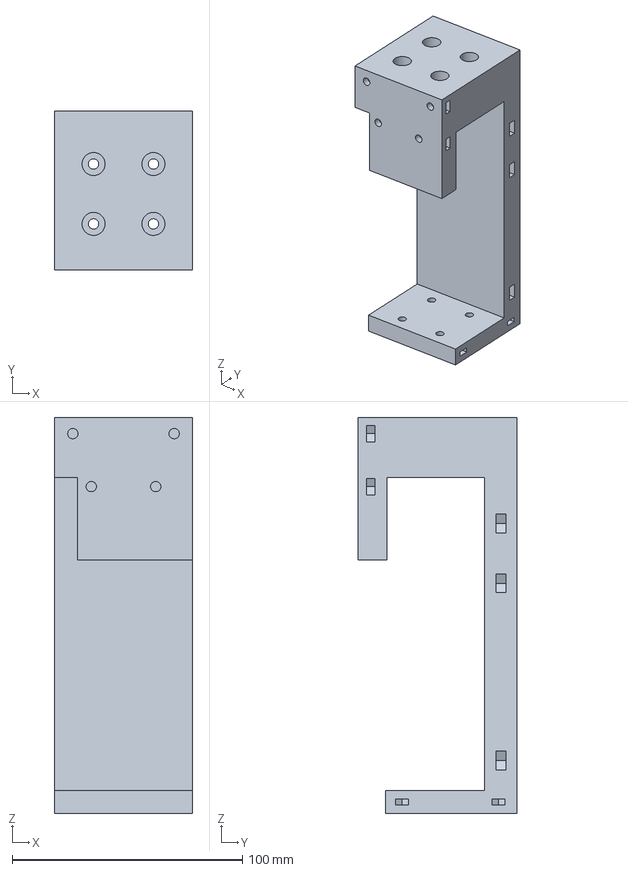
[picture p7: CAD file, 2026-10-24]
cad/x_wagen/x_wagenkoerper.step
60.0 x 69.0 x 172.0 mm
