TobiasRosini/cnc_plasmacutter/cad/y_antrieb/y_umlenkhalter.step

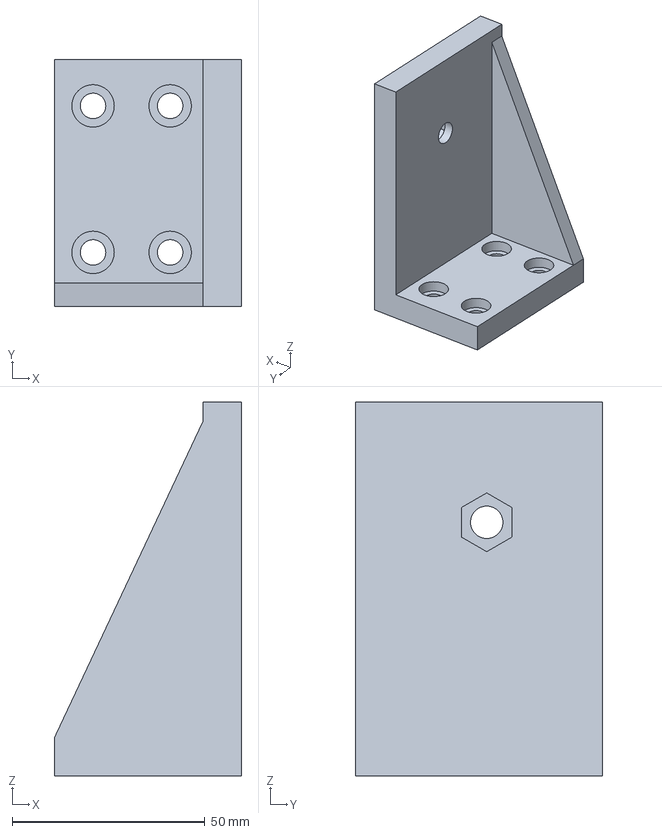
[picture p8: CAD file, 2026-11-03]
cad/y_antrieb/y_umlenkhalter.step
48.5 x 64.0 x 97.0 mm
