TobiasRosini/cnc_plasmacutter/cad/y_portalwinkel/winkel_fest.step

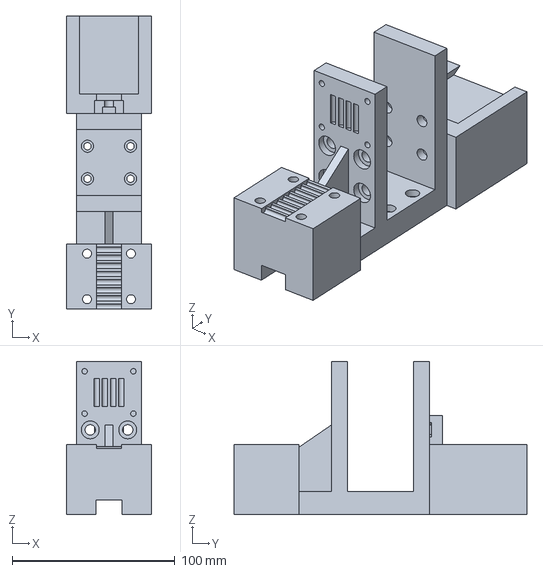
[picture p9: CAD file, 2026-11-04]
cad/y_portalwinkel/winkel_fest.step
52.0 x 180.0 x 94.0 mm
