TobiasRosini/cnc_plasmacutter/cad/z_achse/z_leisten_20x20.step

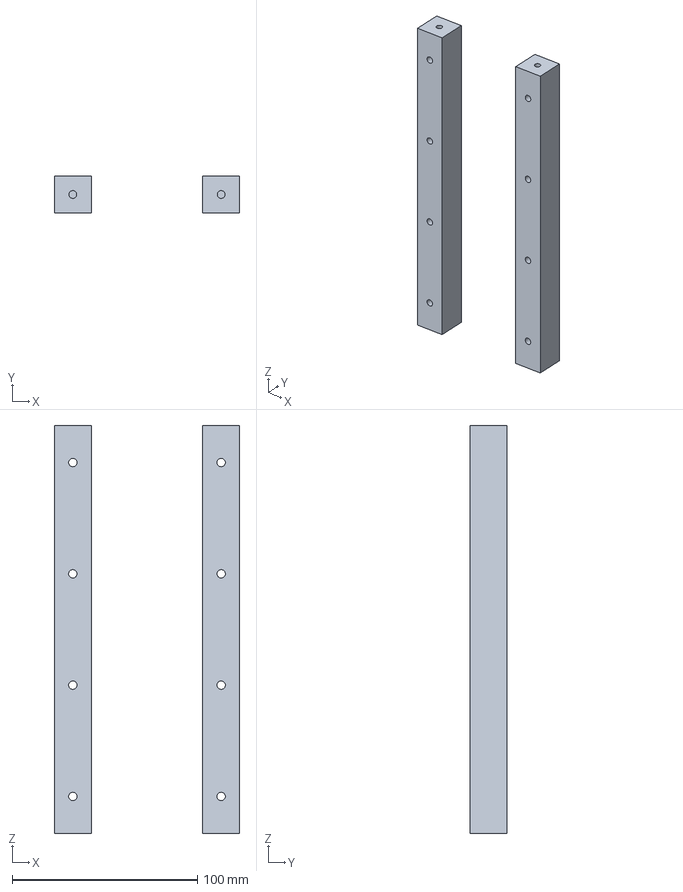
[picture p10: CAD file, 2026-11-04]
cad/z_achse/z_leisten_20x20.step
100.0 x 20.0 x 220.0 mm
