TobiasRosini/cnc_plasmacutter/cad/zusammenbau/zusammenbau.FCStd

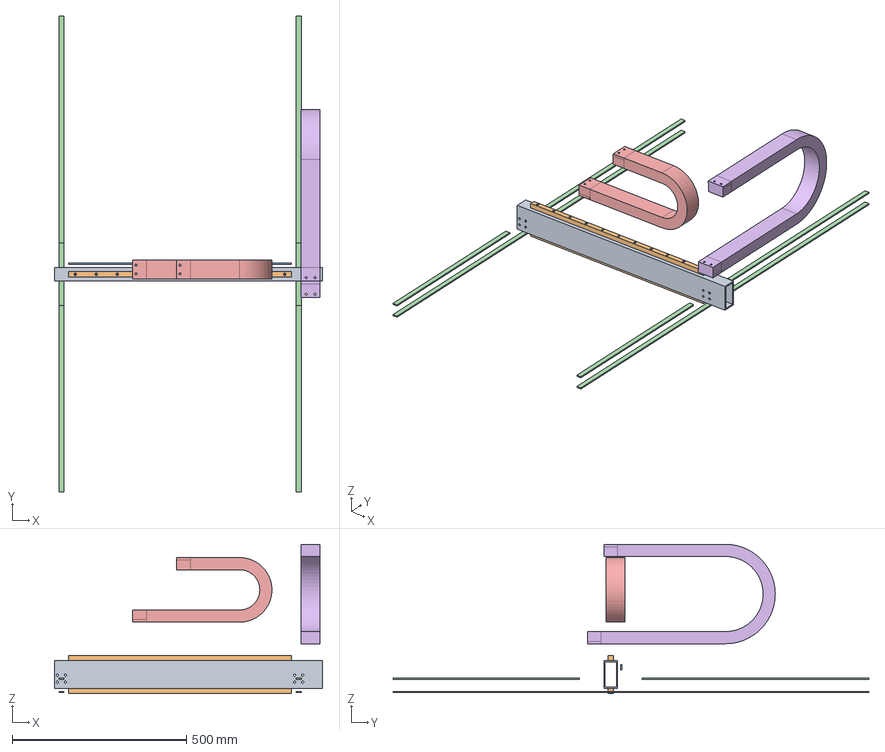
[picture p11: CAD file, 2026-11-12]
cad/zusammenbau/zusammenbau.FCStd
768.5 x 1364.0 x 428.0 mm
031 Portalbruecke_80x40x4 x 2
034 X_Schienen_HGR15 x 2
042 X_Riemen_HTD5M_15 x 2
069+070+071 Y_Riemen_HTD5M_15 x 2
090 X_Kette_igus_2400_03_R75 x 2
091 EK_Kette_igus_2400_03_R125 x 2
