TobiasRosini/cnc_plasmacutter/cad/auflage/kammtraeger.step

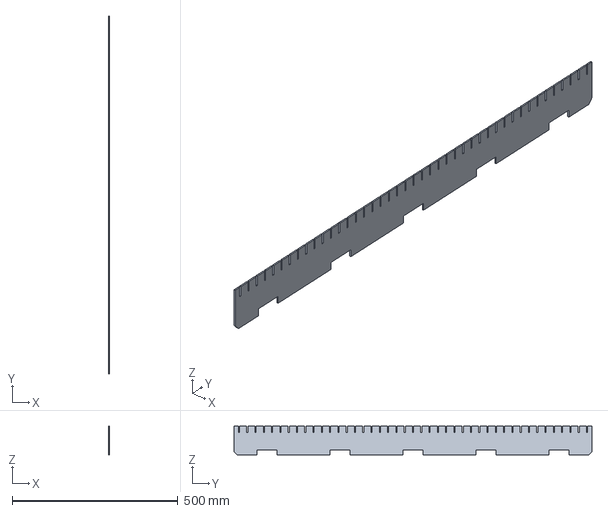
[picture p12: CAD file, 2026-11-04]
cad/auflage/kammtraeger.step
3.00 x 1080.0 x 87.0 mm
