TobiasRosini/cnc_plasmacutter/cad/energiekette/ekx_mastwinkel.step

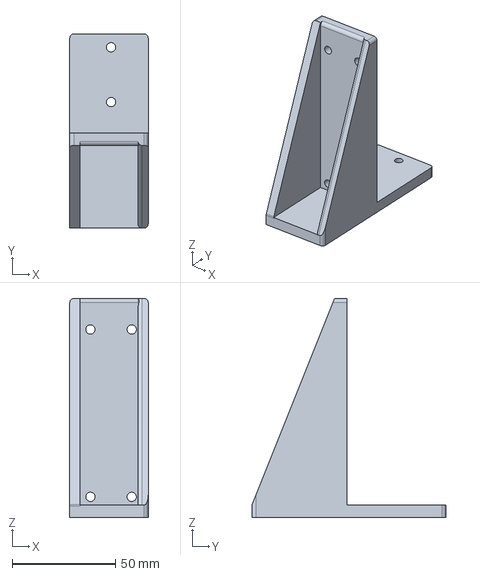
[picture p13: CAD file, 2026-11-12]
cad/energiekette/ekx_mastwinkel.step
38.0 x 94.0 x 106.0 mm
