TobiasRosini/cnc_plasmacutter/cad/unterbau/ub_geraeteboden.step

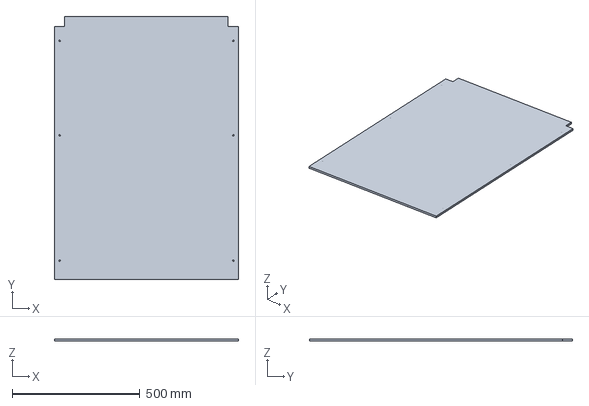
[picture p14: CAD file, 2026-11-09]
cad/unterbau/ub_geraeteboden.step
720.0 x 1030.7 x 9.00 mm
