TobiasRosini/cnc_plasmacutter/cad/x_wagen/x_ref_stift.step

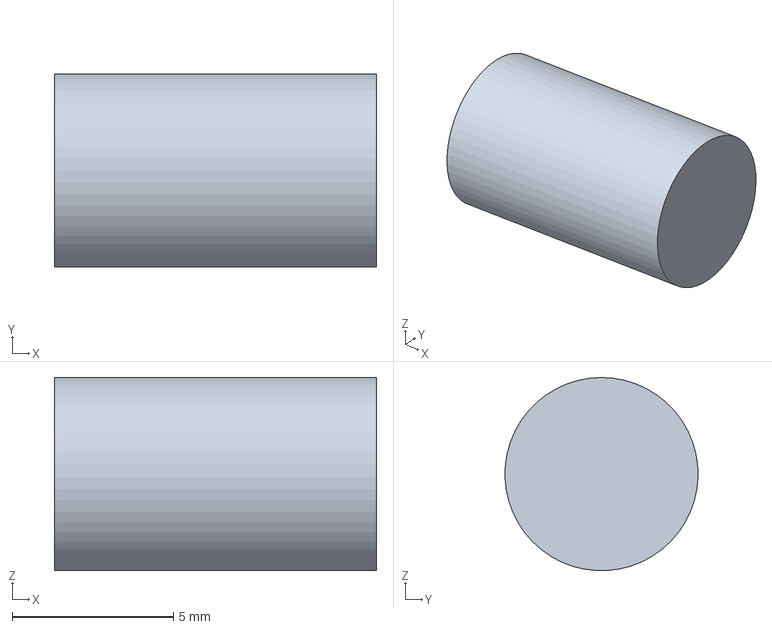
[picture p15: CAD file, 2026-10-24]
cad/x_wagen/x_ref_stift.step
10.0 x 6.00 x 5.99 mm
