TobiasRosini/cnc_plasmacutter/cad/y_antrieb/y_motorhalter.step

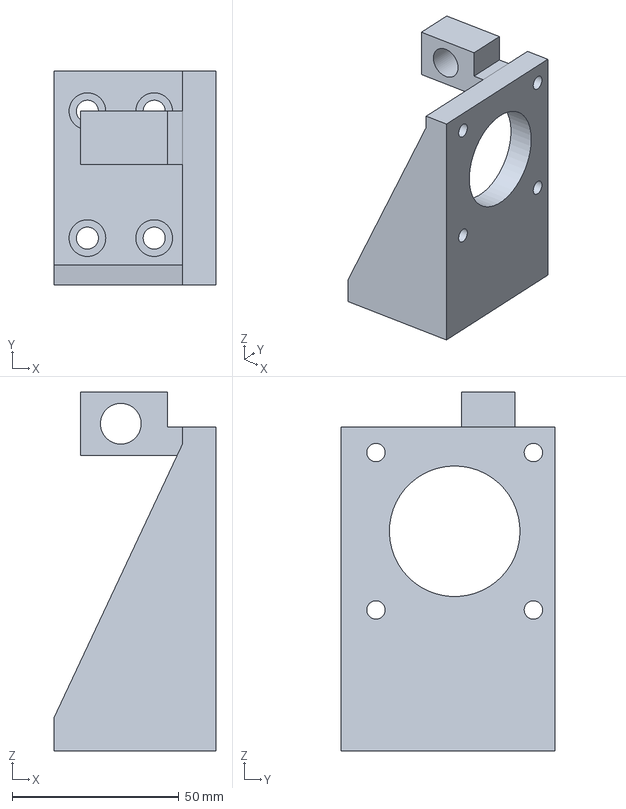
[picture p16: CAD file, 2026-11-03]
cad/y_antrieb/y_motorhalter.step
48.5 x 64.0 x 107.5 mm
