TobiasRosini/cnc_plasmacutter/cad/y_portalwinkel/spannschlitten.step

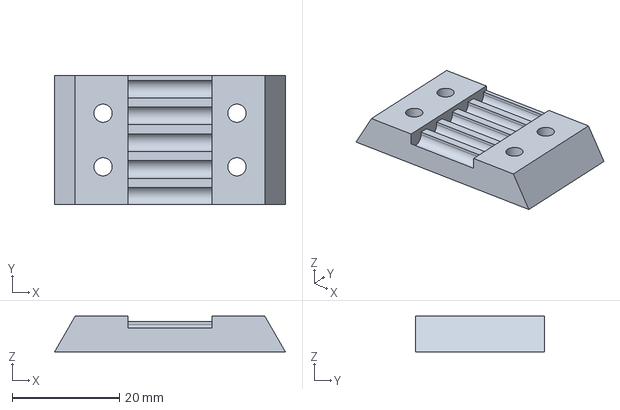
[picture p17: CAD file, 2026-11-04]
cad/y_portalwinkel/spannschlitten.step
43.1 x 24.0 x 6.70 mm
