TobiasRosini/cnc_plasmacutter/cad/z_achse/z_klemmdeckel.step

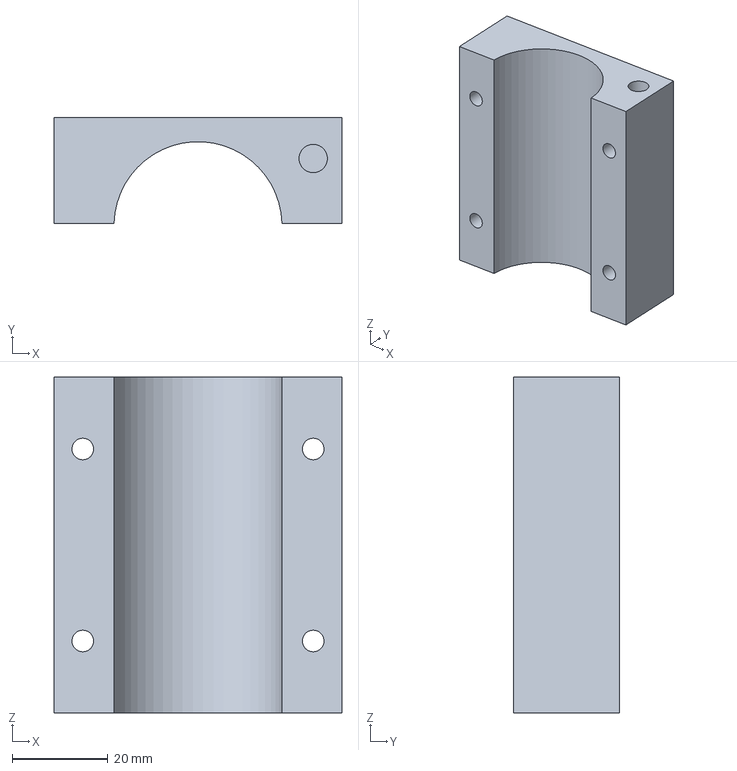
[picture p18: CAD file, 2026-11-04]
cad/z_achse/z_klemmdeckel.step
60.0 x 22.0 x 70.0 mm
