TobiasRosini/cnc_plasmacutter/cad/auflage/auflageleiste.step

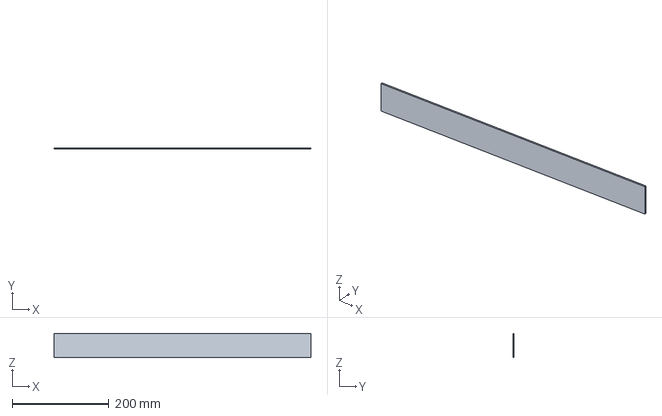
[picture p19: CAD file, 2026-11-04]
cad/auflage/auflageleiste.step
530.0 x 3.00 x 50.0 mm
