TobiasRosini/cnc_plasmacutter/cad/energiekette/ekx_halter.step

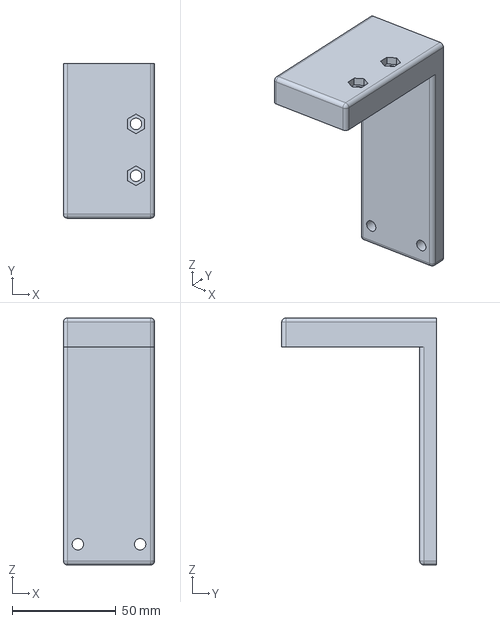
[picture p20: CAD file, 2026-11-12]
cad/energiekette/ekx_halter.step
44.0 x 74.5 x 119.0 mm
