TobiasRosini/cnc_plasmacutter/cad/unterbau/ub_kanalknoten.step

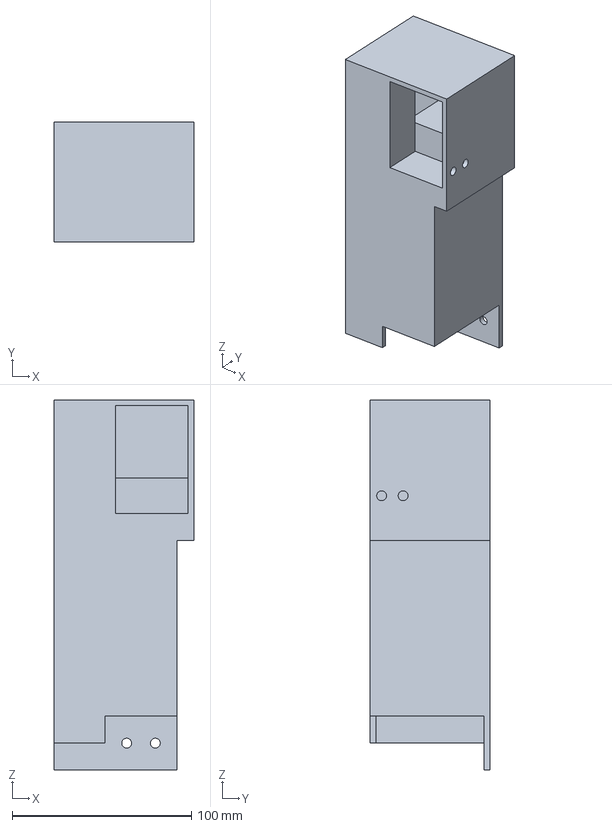
[picture p21: CAD file, 2026-11-09]
cad/unterbau/ub_kanalknoten.step
77.9 x 66.9 x 206.5 mm
