TobiasRosini/cnc_plasmacutter/cad/x_wagen/x_spritzschutz.step

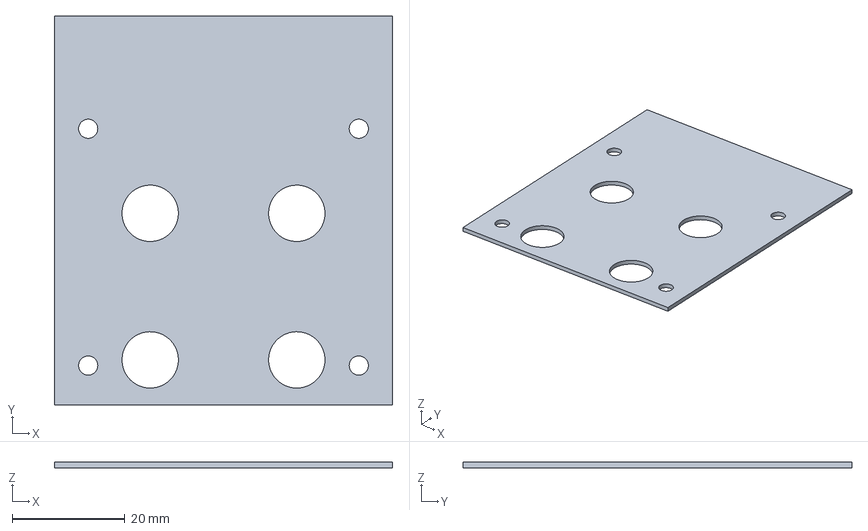
[picture p22: CAD file, 2026-10-24]
cad/x_wagen/x_spritzschutz.step
60.0 x 69.0 x 1.00 mm
