TobiasRosini/cnc_plasmacutter/cad/y_portalwinkel/klemmplatte_schlitten.step

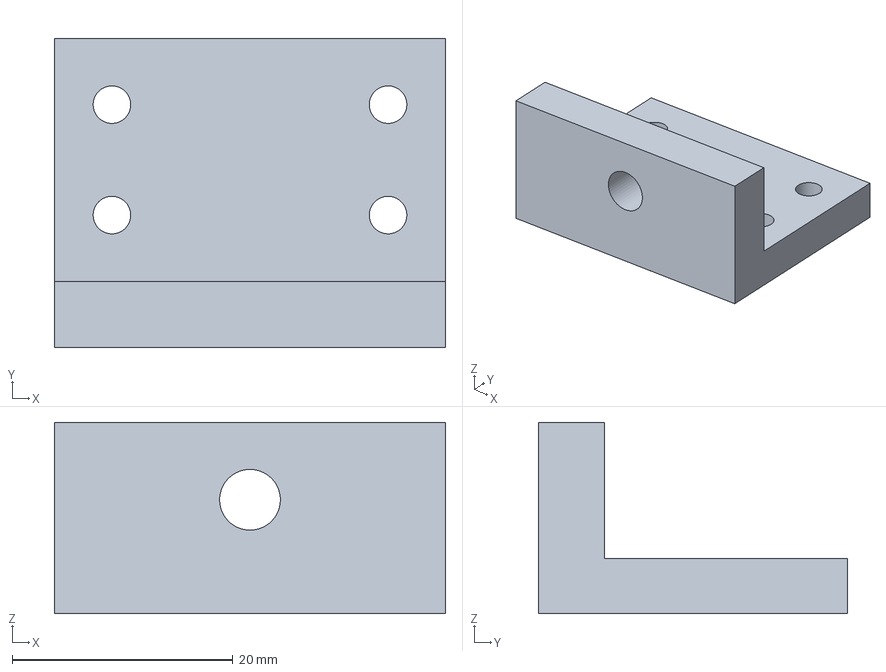
[picture p23: CAD file, 2026-11-04]
cad/y_portalwinkel/klemmplatte_schlitten.step
35.4 x 28.0 x 17.3 mm
