TobiasRosini/cnc_plasmacutter/cad/z_achse/z_achse.FCStd

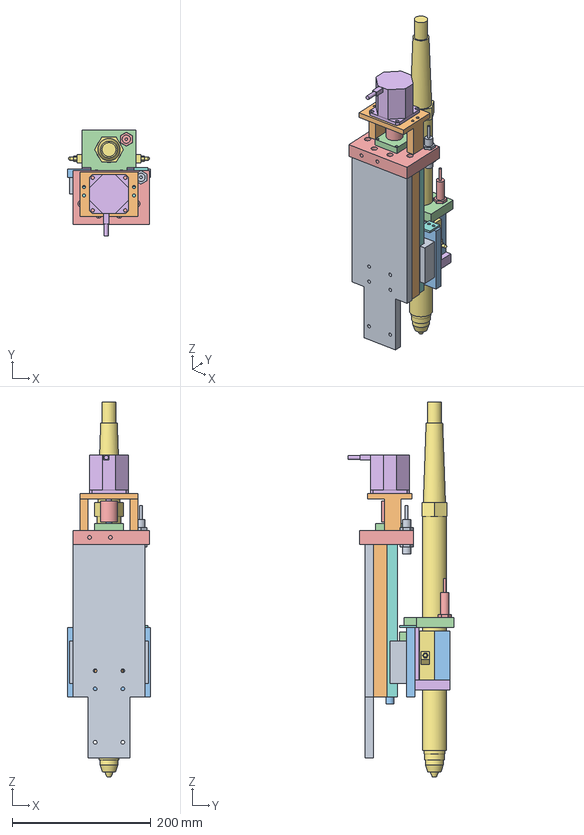
[picture p24: CAD file, 2026-11-04]
cad/z_achse/z_achse.FCStd
120.0 x 152.2 x 540.0 mm
z_grundplatte
z_leisten_20x20
z_schlitten
z_mutterblock
z_kopf
z_halter
z_traeger
Z_Schienen_HGR15
Z_Wagen_HGH15CA
Z_Mutter_SFU1204
Z_Spindel_SFU1204
Z_Festlager_FK10
Z_Kupplung
Z_Motor_NEMA23
Brenner_SP80M
z_ref_fahne
Z_Referenzschalter
z_motorhalter
z_klemmdeckel
z_halter_oben
Z_Schalter_Schwimmkopf
Z_Zielstift_6x10
Z_Schmiernippel_M6
