TobiasRosini/cnc_plasmacutter/cad/energiekette/energiekette.FCStd

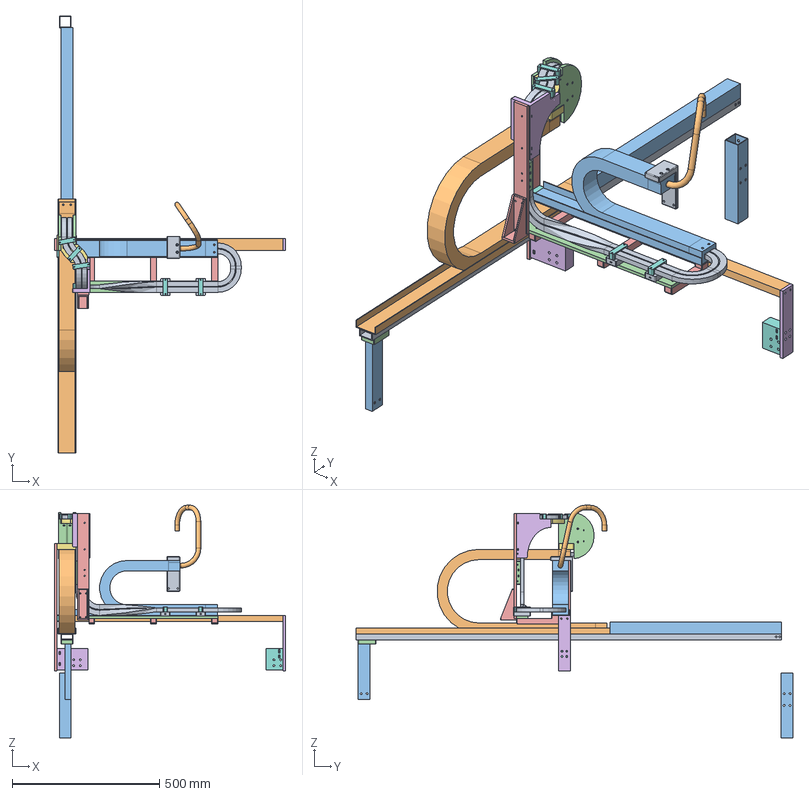
[picture p25: CAD file, 2026-11-12]
cad/energiekette/energiekette.FCStd
784.5 x 1483.5 x 790.0 mm
ek_traeger_40x20
ek_rinne
ek_stuetzen
ek_stuetzen_kopf
ek_ausleger
ek_einsteckteil
ek_halter_y
ekx_ablagehalter
ek_Leitung
ekx_traeger_40x20
ekx_rinne
ekx_rinne_hinten
ekx_rinnenhalter
ekx_stuetze_links
ekx_stopfen
ek_einsteckteil_links
ekx_halter
ekx_Leitung_Brenner
ek_kabelkanal
ek_leitungsbogen
ekx_mast
ekx_umlenkkopf
ek_verbindungsplatte
ek_leitungsschellen
ekx_leitungssockel
Kette_igus_2400_03_R125
Kette_X_igus_2400_03_R75
ekx_distanzstueck
ekx_mastwinkel
