TobiasRosini/cnc_plasmacutter/cad/unterbau/unterbau.FCStd

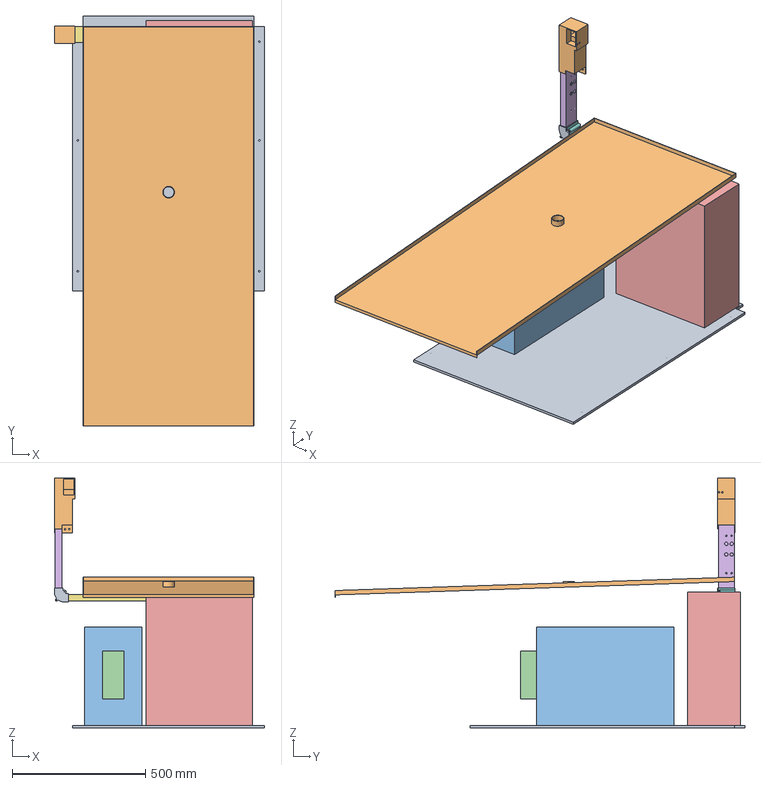
[picture p26: CAD file, 2026-11-09]
cad/unterbau/unterbau.FCStd
788.5 x 1536.0 x 936.5 mm
ub_geraeteboden
ub_tropfboden
Plasmageraet_XPro_CUT_70CNC
Druckluft_Einheit
Schaltschrank_400x500x200
ub_kabelkanal_senkrecht
ub_kabelkanal_quer
ub_uebergang_unten
ub_uebergang_unten_deckel
ub_kanalknoten
