TobiasRosini/cnc_plasmacutter/cad/x_wagen/x_motorbock.step

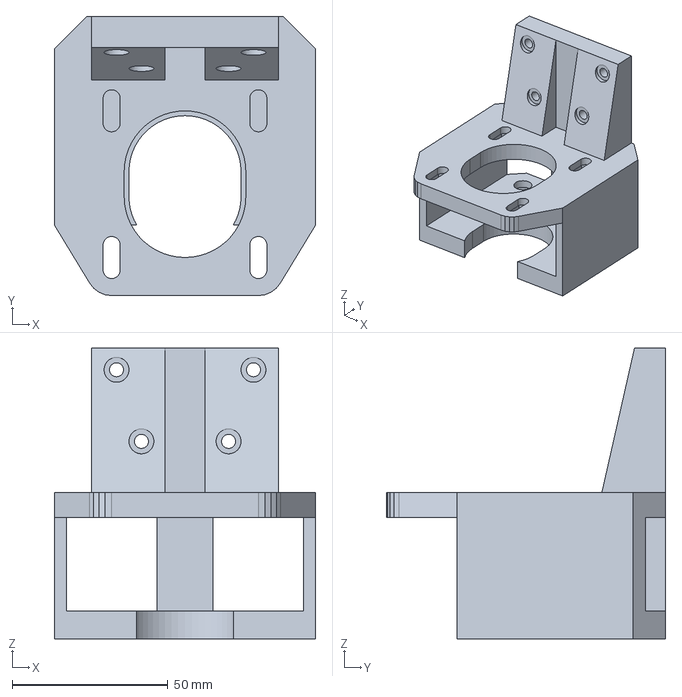
[picture p27: CAD file, 2026-10-24]
cad/x_wagen/x_motorbock.step
84.0 x 89.7 x 93.5 mm
