TobiasRosini/cnc_plasmacutter/cad/y_antrieb/y_antrieb.FCStd

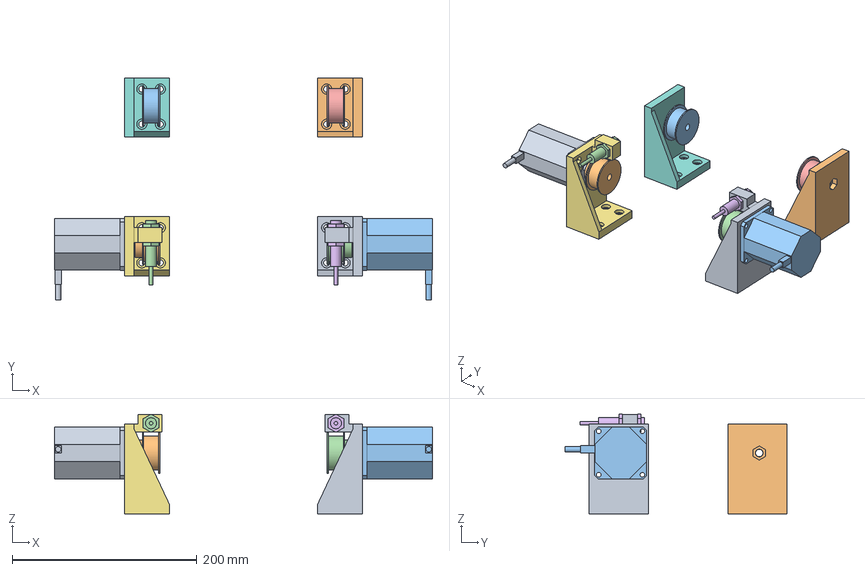
[picture p28: CAD file, 2026-11-03]
cad/y_antrieb/y_antrieb.FCStd
409.0 x 240.2 x 107.8 mm
y_motorhalter
y_umlenkhalter
Motor_Y
Riemenscheibe_Y
Umlenkrolle_Y
Referenzschalter_Y
y_motorhalter_l
y_umlenkhalter_l
Motor_Y_l
Riemenscheibe_Y_l
Umlenkrolle_Y_l
Referenzschalter_Y_l
