TobiasRosini/cnc_plasmacutter/cad/y_portalwinkel/y_portalwinkel.FCStd

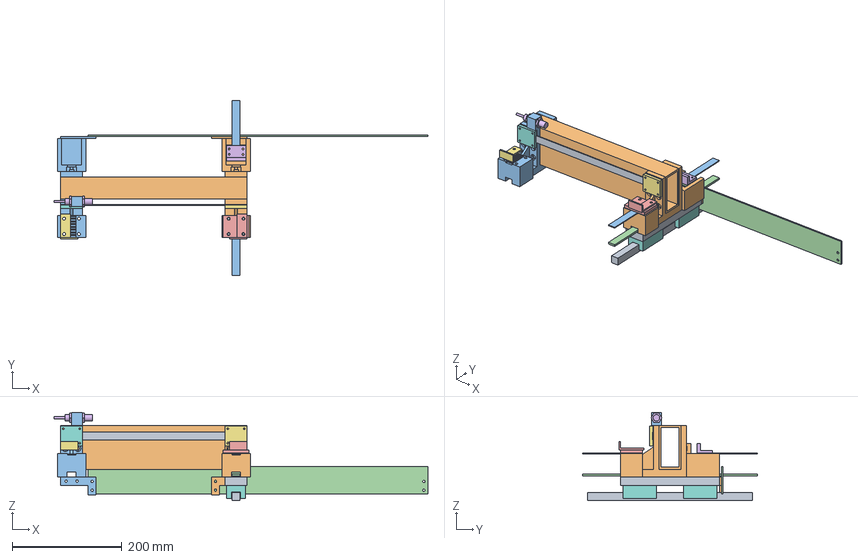
[picture p29: CAD file, 2026-11-04]
cad/y_portalwinkel/y_portalwinkel.FCStd
682.0 x 320.0 x 161.0 mm
Flachstange_40x15
winkel_fest
winkel_kasten
spannschlitten
klemmplatte_fest
klemmplatte_schlitten
x_klemmplatte
Wagen_HGH15CA
Schiene_HGR15
Bruecke_80x40x4
Riemen_HTD5M_15
Riemen_Ruecktrum
y_ref_fahne
Referenzschalter_X
y_ref_fahne_rechts
x_klemmplatte_rechts
Riemen_X
x_schutz_halter
x_schutz_halter_rechts
x_schutzstreifen
