TobiasRosini/cnc_plasmacutter/cad/z_achse/z_traeger.step

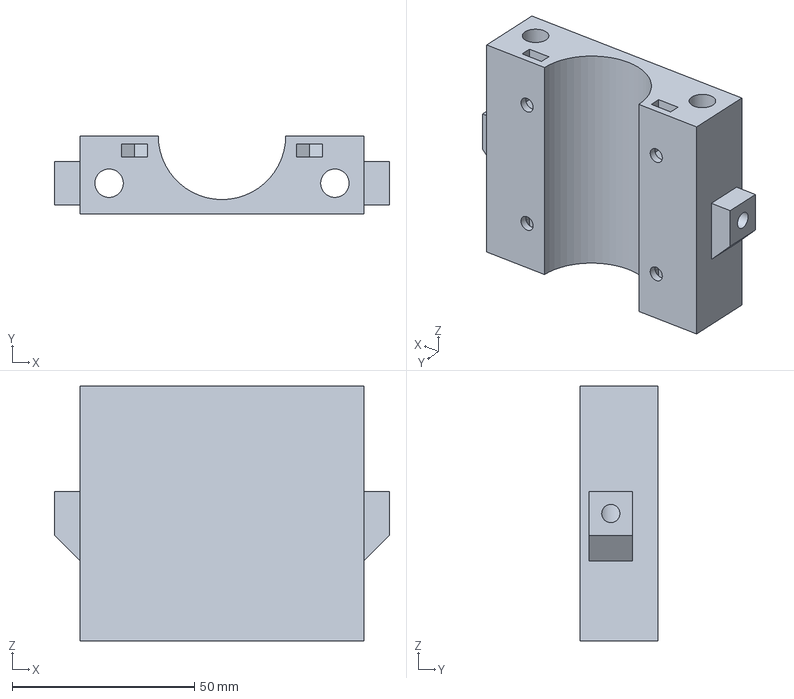
[picture p30: CAD file, 2026-11-04]
cad/z_achse/z_traeger.step
92.0 x 21.5 x 70.0 mm
