TobiasRosini/cnc_plasmacutter/cad/energiekette/ek_leitungsschelle.step

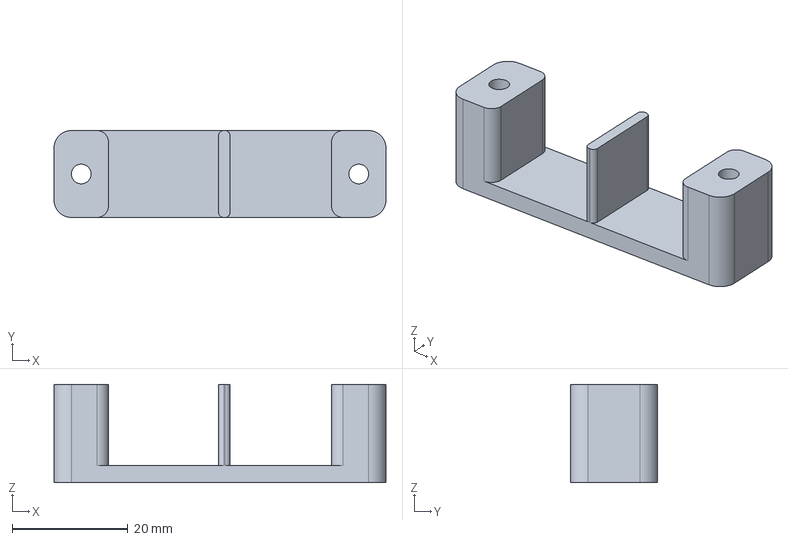
[picture p31: CAD file, 2026-11-12]
cad/energiekette/ek_leitungsschelle.step
57.3 x 15.0 x 17.0 mm
