TobiasRosini/cnc_plasmacutter/cad/unterbau/ub_uebergang_unten.step

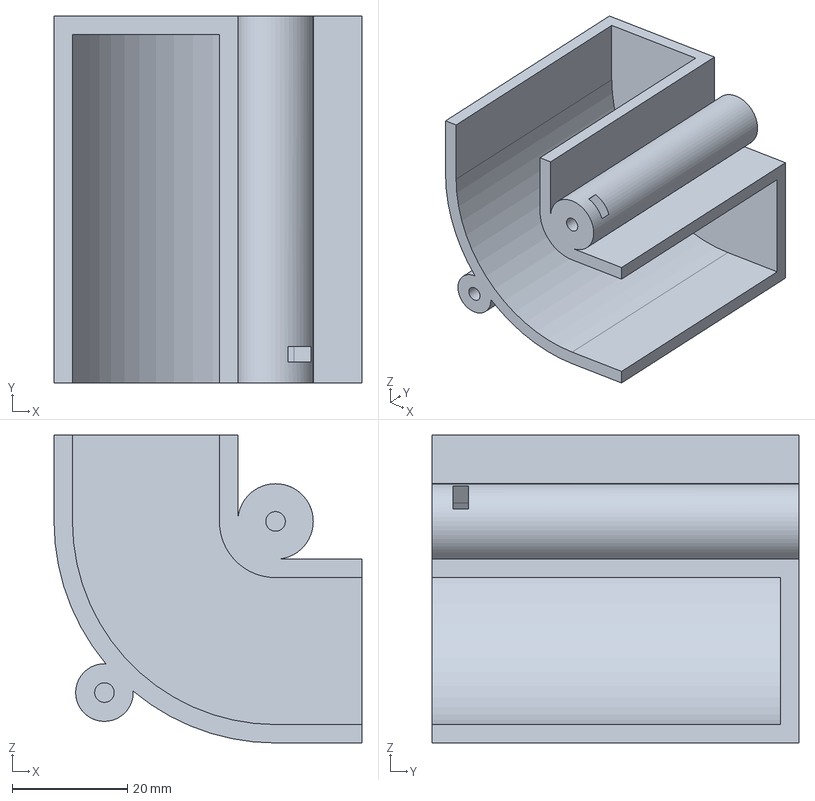
[picture p32: CAD file, 2026-11-09]
cad/unterbau/ub_uebergang_unten.step
53.5 x 63.7 x 53.5 mm
