TobiasRosini/cnc_plasmacutter/cad/x_wagen/x_wagen.FCStd

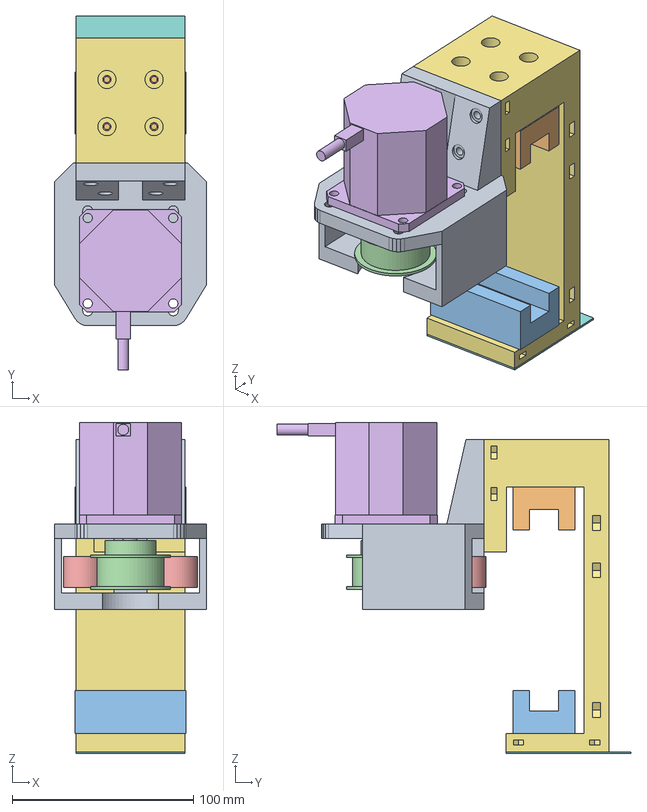
[picture p33: CAD file, 2026-10-24]
cad/x_wagen/x_wagen.FCStd
84.0 x 195.1 x 182.5 mm
x_motorbock
Wagen_X_oben
Wagen_X_unten
Riemenscheibe_X
Umlenkrollen_X
Motor_X_NEMA23
x_wagenkoerper
x_spritzschutz
x_ref_stift
