TobiasRosini/cnc_plasmacutter/cad/y_portalwinkel/x_klemmplatte.step

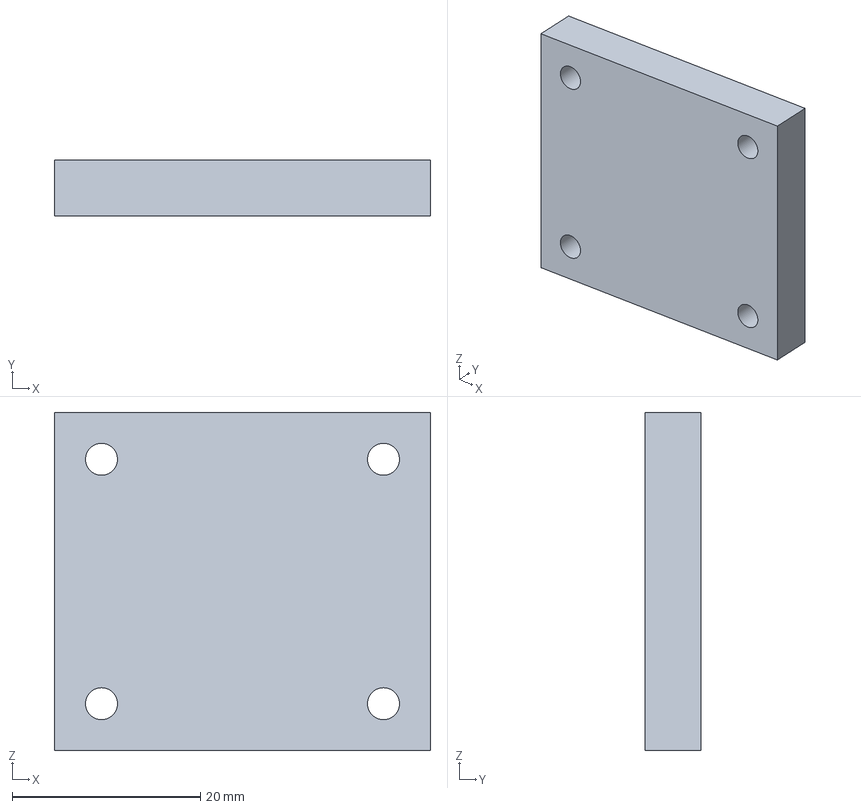
[picture p34: CAD file, 2026-11-04]
cad/y_portalwinkel/x_klemmplatte.step
40.0 x 6.00 x 36.0 mm
