TobiasRosini/cnc_plasmacutter/cad/z_achse/z_mutterblock.step

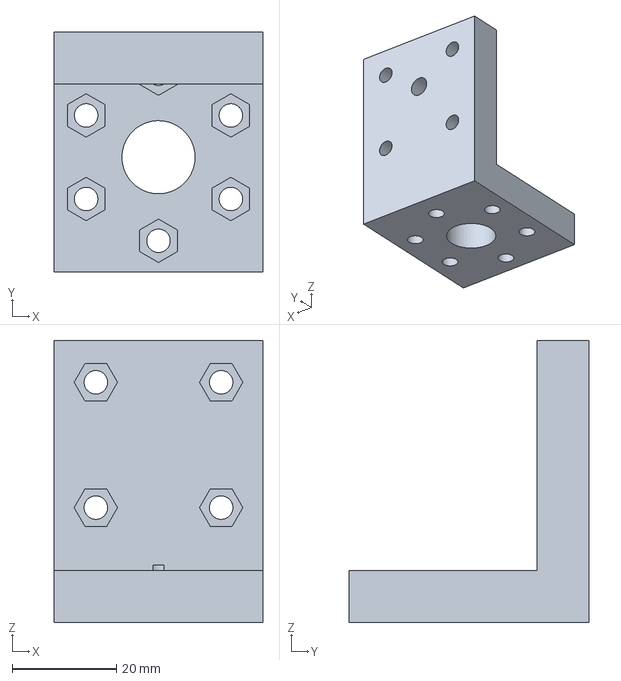
[picture p35: CAD file, 2026-11-04]
cad/z_achse/z_mutterblock.step
40.0 x 46.0 x 54.0 mm
