TobiasRosini/cnc_plasmacutter/cad/energiekette/ekx_stopfen.step

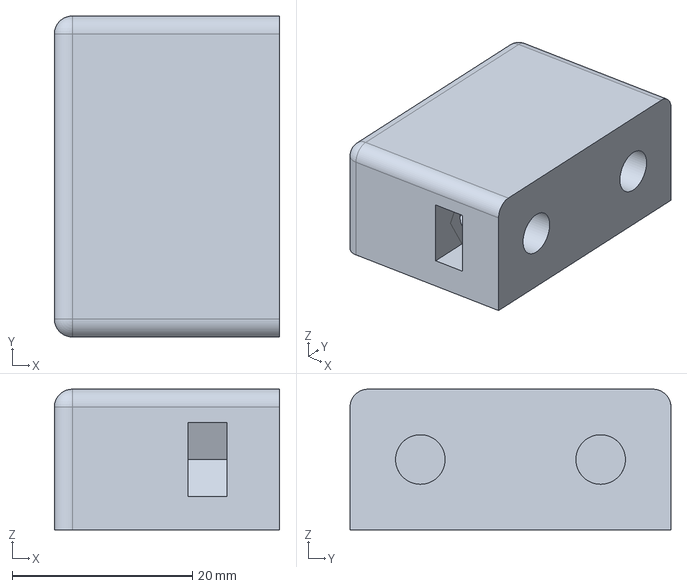
[picture p36: CAD file, 2026-11-12]
cad/energiekette/ekx_stopfen.step
25.0 x 35.6 x 15.6 mm
