TobiasRosini/cnc_plasmacutter/cad/unterbau/ub_uebergang_unten_deckel.step

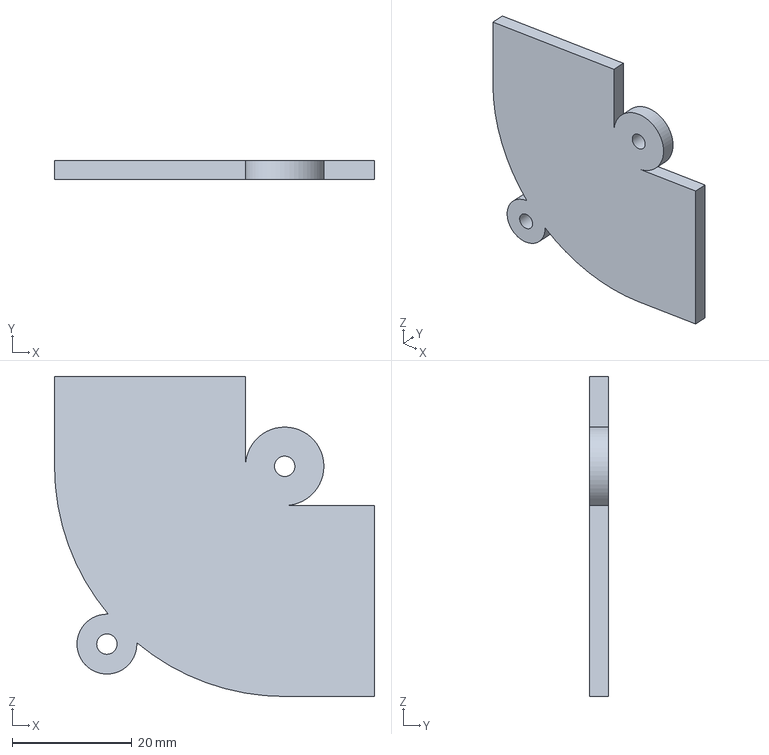
[picture p37: CAD file, 2026-11-09]
cad/unterbau/ub_uebergang_unten_deckel.step
53.5 x 3.20 x 53.5 mm
