TobiasRosini/cnc_plasmacutter/cad/y_portalwinkel/flachstange_40x15.step

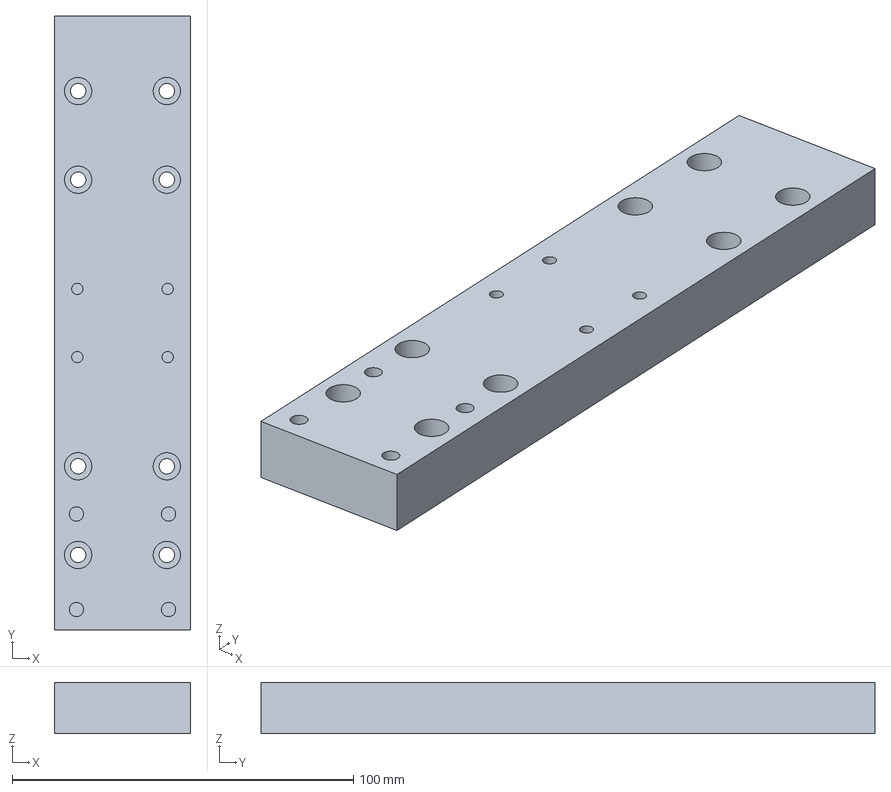
[picture p38: CAD file, 2026-11-04]
cad/y_portalwinkel/flachstange_40x15.step
40.0 x 180.0 x 15.0 mm
