TobiasRosini/cnc_plasmacutter/cad/z_achse/z_halter.step

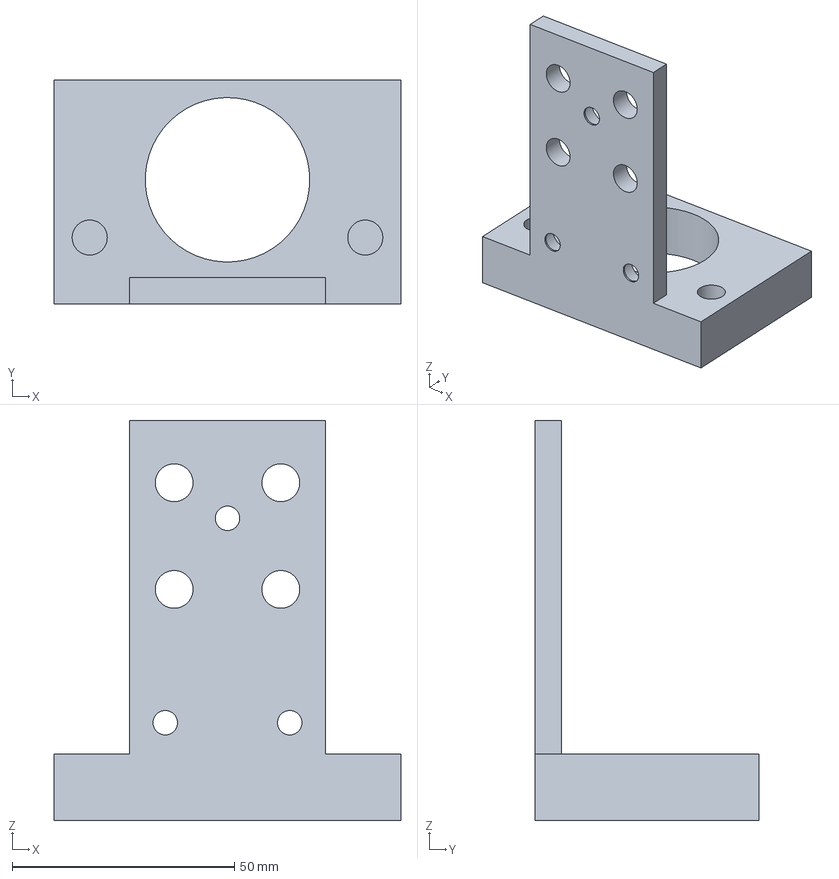
[picture p39: CAD file, 2026-11-04]
cad/z_achse/z_halter.step
78.0 x 50.5 x 90.0 mm
