TobiasRosini/cnc_plasmacutter/cad/energiekette/ekx_distanzstueck.step

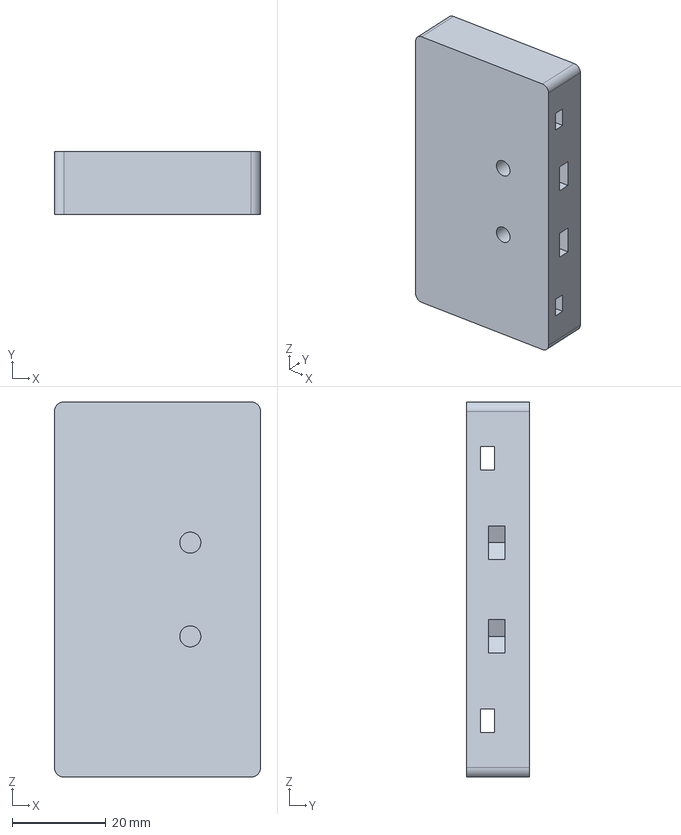
[picture p40: CAD file, 2026-11-12]
cad/energiekette/ekx_distanzstueck.step
44.0 x 13.5 x 80.0 mm
