TobiasRosini/cnc_plasmacutter/cad/y_portalwinkel/klemmplatte_fest.step

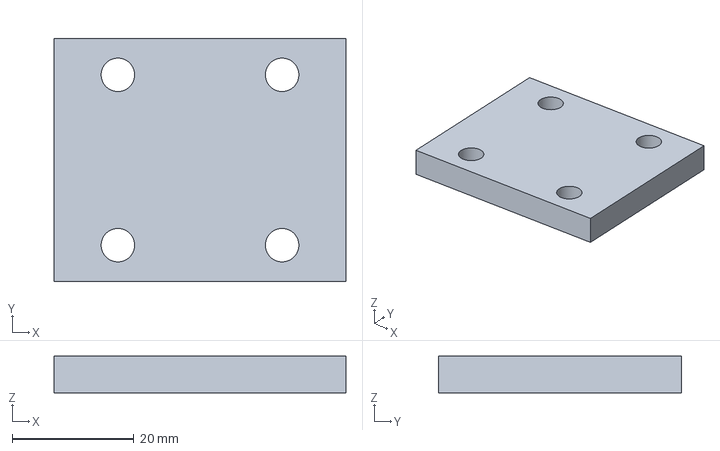
[picture p41: CAD file, 2026-11-04]
cad/y_portalwinkel/klemmplatte_fest.step
48.0 x 40.0 x 6.00 mm
