TobiasRosini/cnc_plasmacutter/cad/z_achse/z_kopf.step

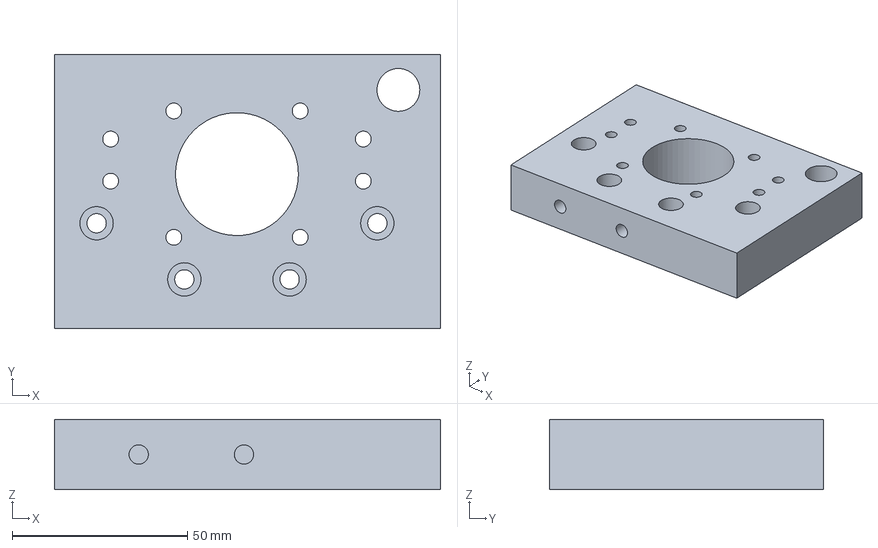
[picture p42: CAD file, 2026-11-04]
cad/z_achse/z_kopf.step
110.0 x 78.1 x 20.0 mm
