TobiasRosini/cnc_plasmacutter/cad/energiekette/ek_einsteckteil_links.step

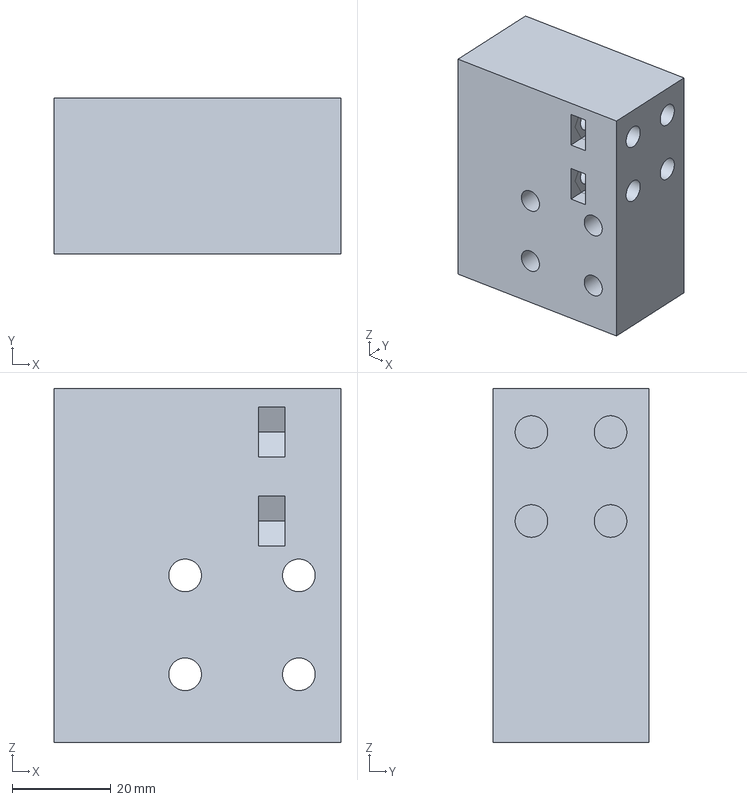
[picture p43: CAD file, 2026-11-12]
cad/energiekette/ek_einsteckteil_links.step
58.0 x 31.6 x 71.6 mm
