TobiasRosini/cnc_plasmacutter/cad/y_portalwinkel/winkel_kasten.step

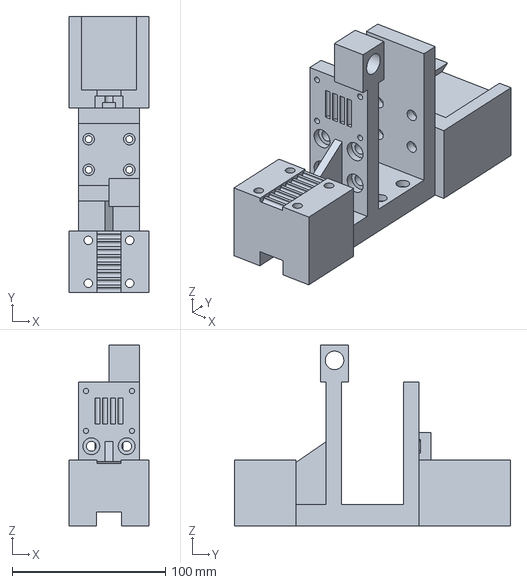
[picture p44: CAD file, 2026-11-04]
cad/y_portalwinkel/winkel_kasten.step
52.0 x 180.0 x 118.0 mm
