TobiasRosini/cnc_plasmacutter/cad/z_achse/z_halter_oben.step

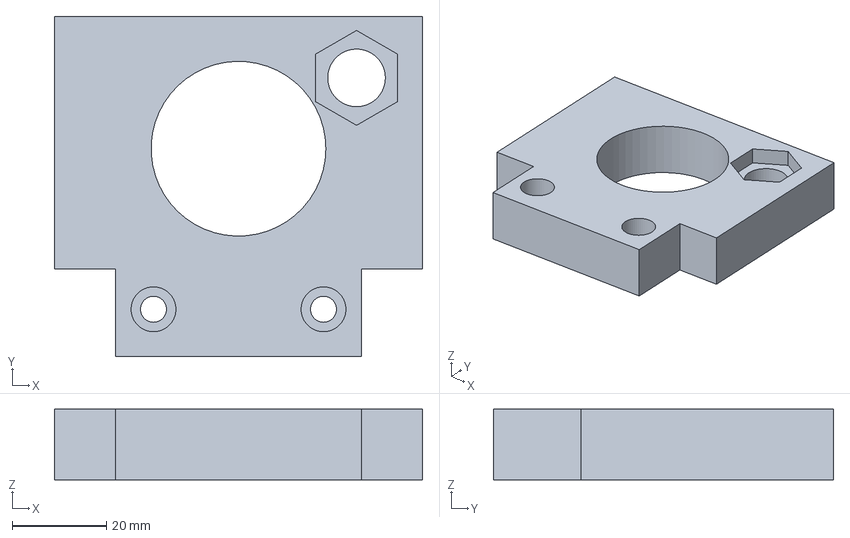
[picture p45: CAD file, 2026-11-04]
cad/z_achse/z_halter_oben.step
78.0 x 72.0 x 15.0 mm
