TobiasRosini/cnc_plasmacutter/cad/energiekette/ek_leitungsbogen_a.step

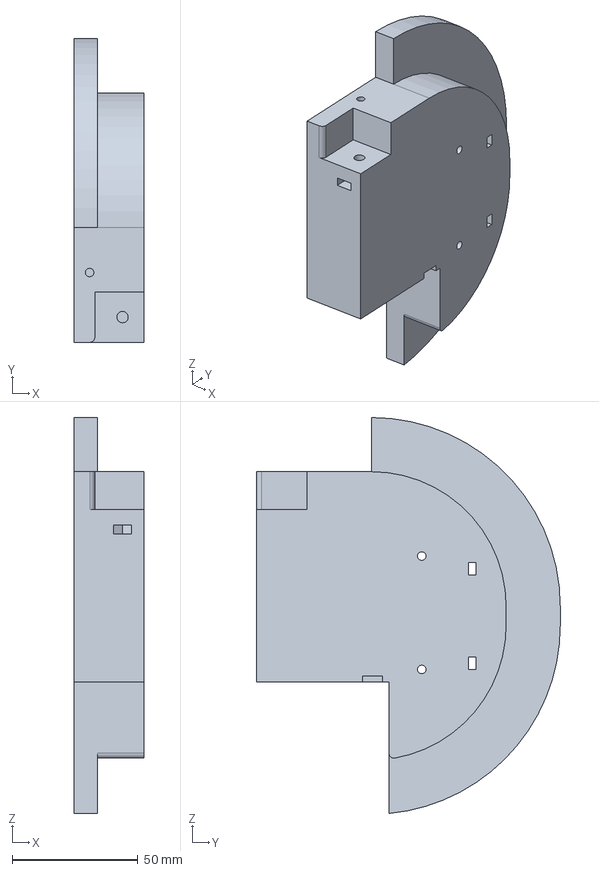
[picture p46: CAD file, 2026-11-12]
cad/energiekette/ek_leitungsbogen_a.step
27.8 x 120.5 x 157.2 mm
