TobiasRosini/cnc_plasmacutter/cad/z_achse/z_grundplatte.step

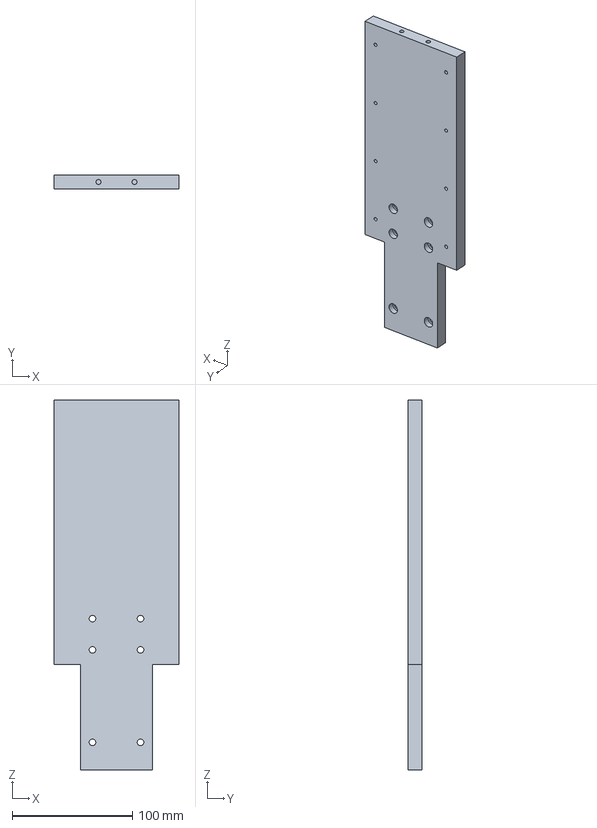
[picture p47: CAD file, 2026-11-04]
cad/z_achse/z_grundplatte.step
104.0 x 12.0 x 308.0 mm
