TobiasRosini/cnc_plasmacutter/cad/energiekette/ek_verbindungsplatte.step

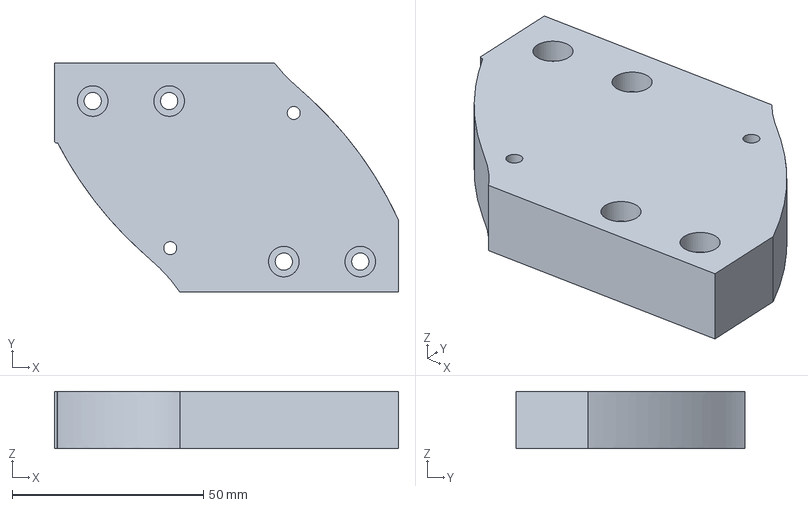
[picture p48: CAD file, 2026-11-12]
cad/energiekette/ek_verbindungsplatte.step
90.0 x 60.0 x 15.0 mm
