TobiasRosini/cnc_plasmacutter/cad/z_achse/z_schlitten.step

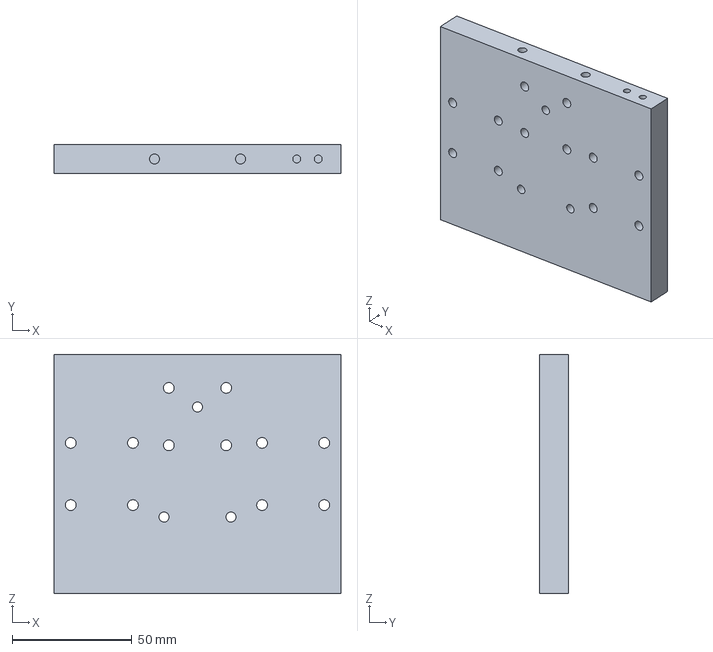
[picture p49: CAD file, 2026-11-04]
cad/z_achse/z_schlitten.step
120.0 x 12.0 x 100.0 mm
