TobiasRosini/cnc_plasmacutter/cad/energiekette/ek_rinne.step

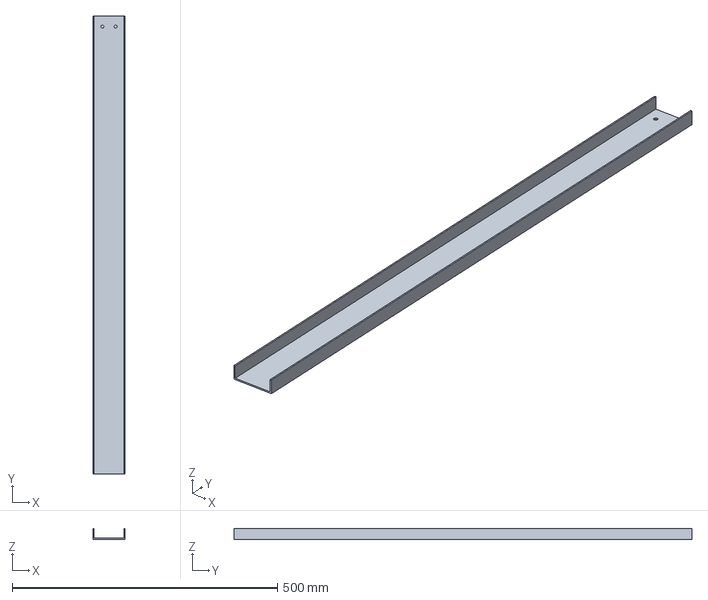
[picture p50: CAD file, 2026-11-12]
cad/energiekette/ek_rinne.step
60.0 x 862.8 x 20.0 mm
