TobiasRosini/cnc_plasmacutter/cad/z_achse/z_ref_fahne.step

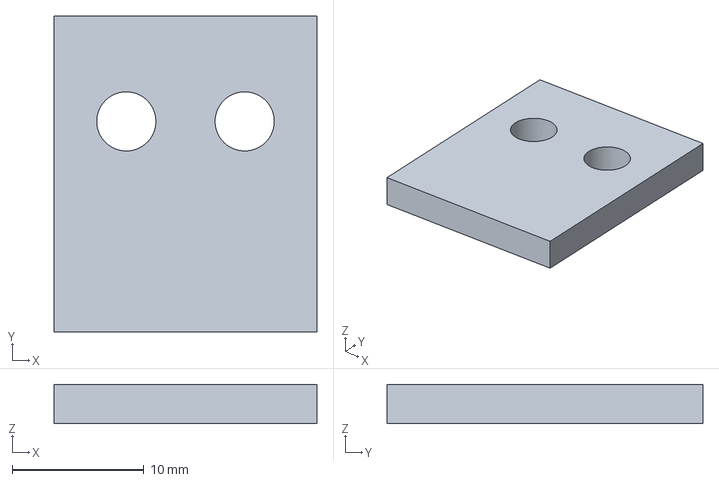
[picture p51: CAD file, 2026-11-04]
cad/z_achse/z_ref_fahne.step
20.0 x 24.0 x 3.00 mm
