TobiasRosini/cnc_plasmacutter/cad/energiekette/ek_leitungsbogen_b.step

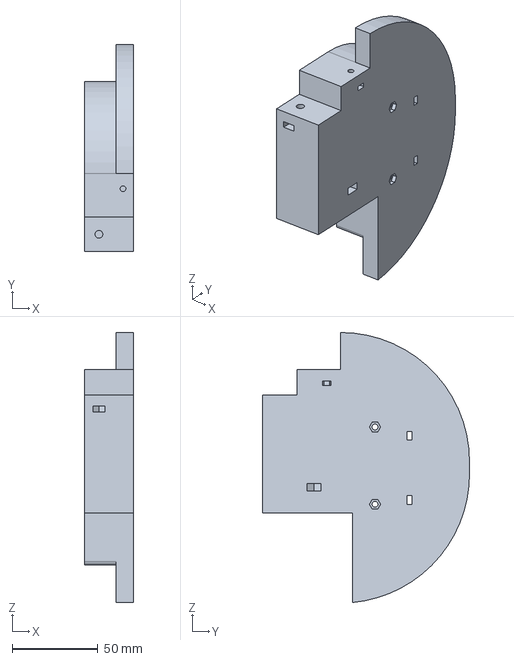
[picture p52: CAD file, 2026-11-12]
cad/energiekette/ek_leitungsbogen_b.step
28.7 x 120.5 x 157.2 mm
