TobiasRosini/cnc_plasmacutter/cad/z_achse/z_motorhalter.step

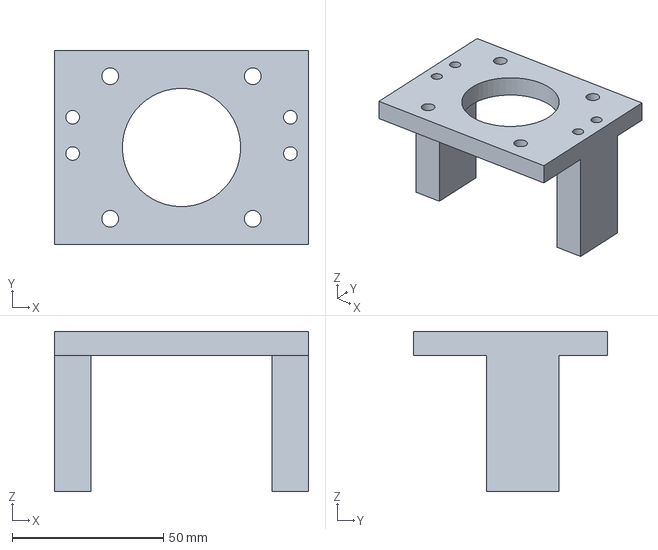
[picture p53: CAD file, 2026-11-04]
cad/z_achse/z_motorhalter.step
84.0 x 64.0 x 53.0 mm
