TobiasRosini/cnc_plasmacutter/cad/energiekette/ekx_ablagehalter.step

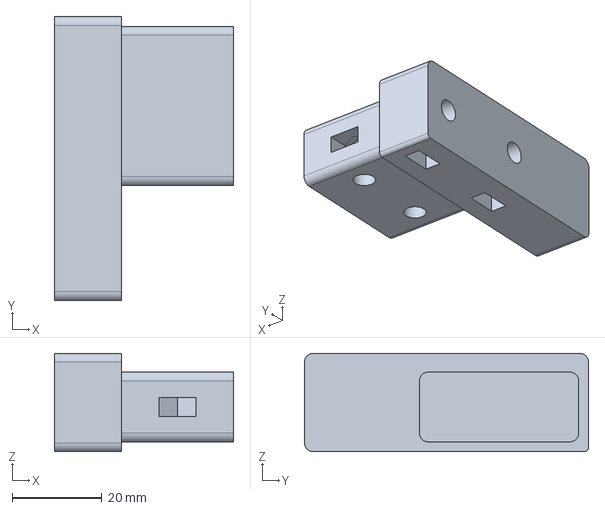
[picture p54: CAD file, 2026-11-12]
cad/energiekette/ekx_ablagehalter.step
40.0 x 63.5 x 22.0 mm
