TobiasRosini/cnc_plasmacutter/cad/energiekette/ekx_rinnenhalter.step

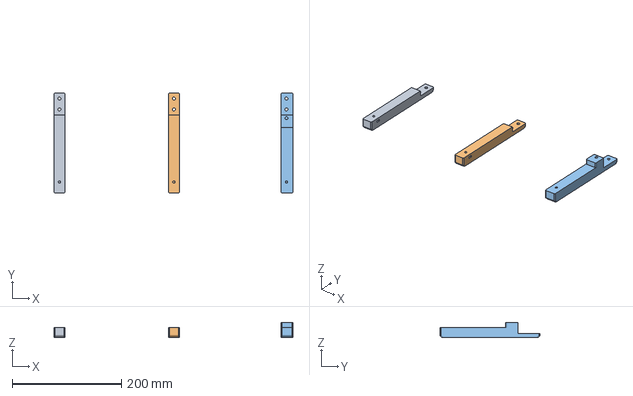
[picture p55: CAD file, 2026-11-12]
cad/energiekette/ekx_rinnenhalter.step
438.4 x 183.0 x 28.0 mm
