TobiasRosini/cnc_plasmacutter/cad/energiekette/ekx_leitungssockel.step

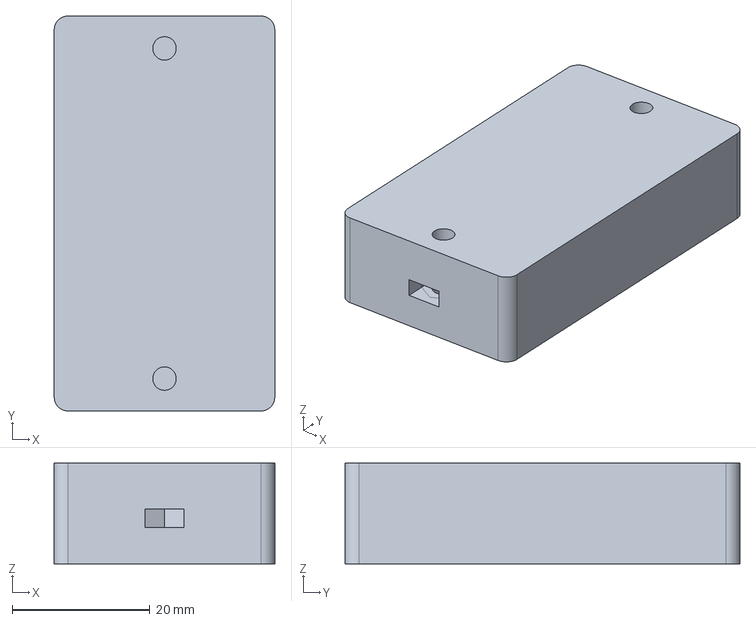
[picture p56: CAD file, 2026-11-12]
cad/energiekette/ekx_leitungssockel.step
32.0 x 57.3 x 14.6 mm
