TobiasRosini/cnc_plasmacutter/cad/energiekette/ekx_rinne_hinten.step

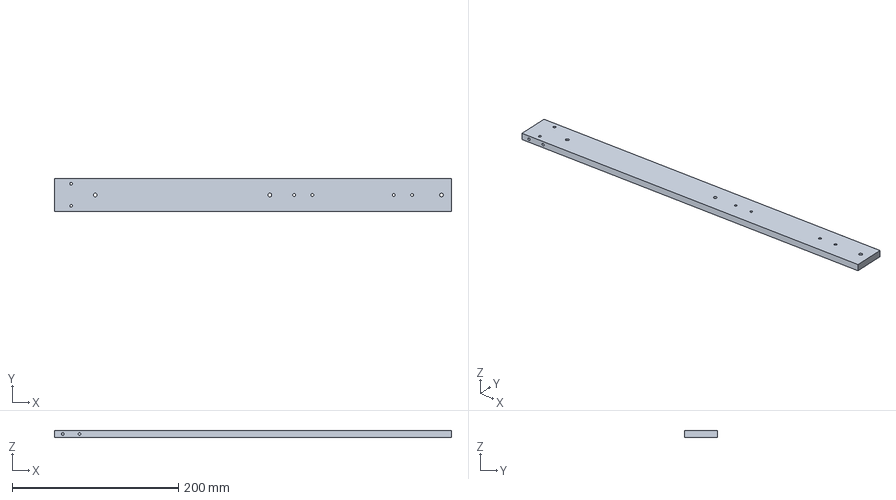
[picture p57: CAD file, 2026-11-12]
cad/energiekette/ekx_rinne_hinten.step
477.4 x 40.0 x 8.00 mm
