TobiasRosini/cnc_plasmacutter/cad/energiekette/ekx_mast.step

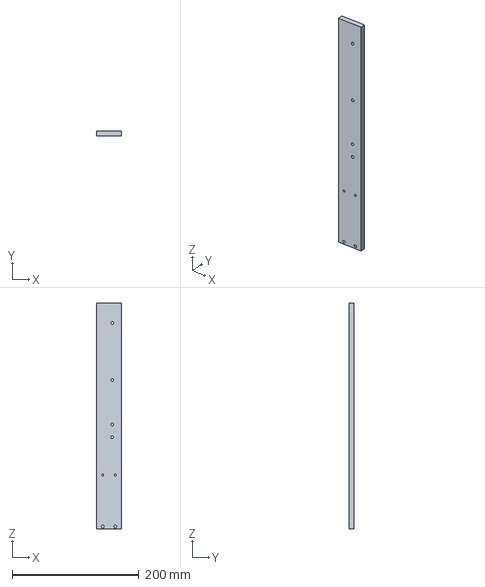
[picture p58: CAD file, 2026-11-12]
cad/energiekette/ekx_mast.step
40.0 x 8.00 x 356.1 mm
