TobiasRosini/cnc_plasmacutter/cad/energiekette/ek_ausleger.step

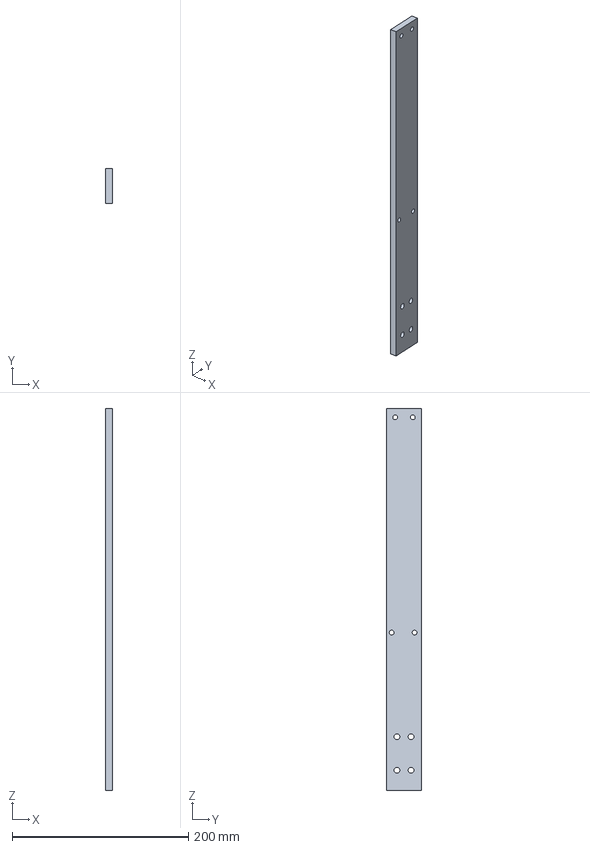
[picture p59: CAD file, 2026-11-12]
cad/energiekette/ek_ausleger.step
8.00 x 40.0 x 433.0 mm
