TobiasRosini/cnc_plasmacutter/cad/energiekette/ek_leitungsbogen_steg.step

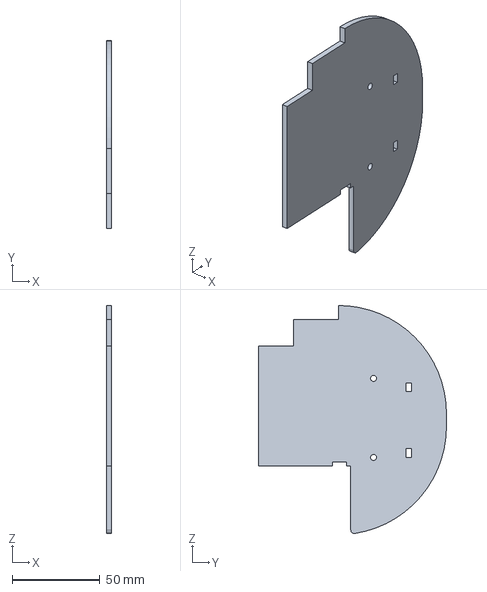
[picture p60: CAD file, 2026-11-12]
cad/energiekette/ek_leitungsbogen_steg.step
3.00 x 107.0 x 129.8 mm
