TobiasRosini/cnc_plasmacutter/cad/energiekette/ek_stuetzen_kopf.step

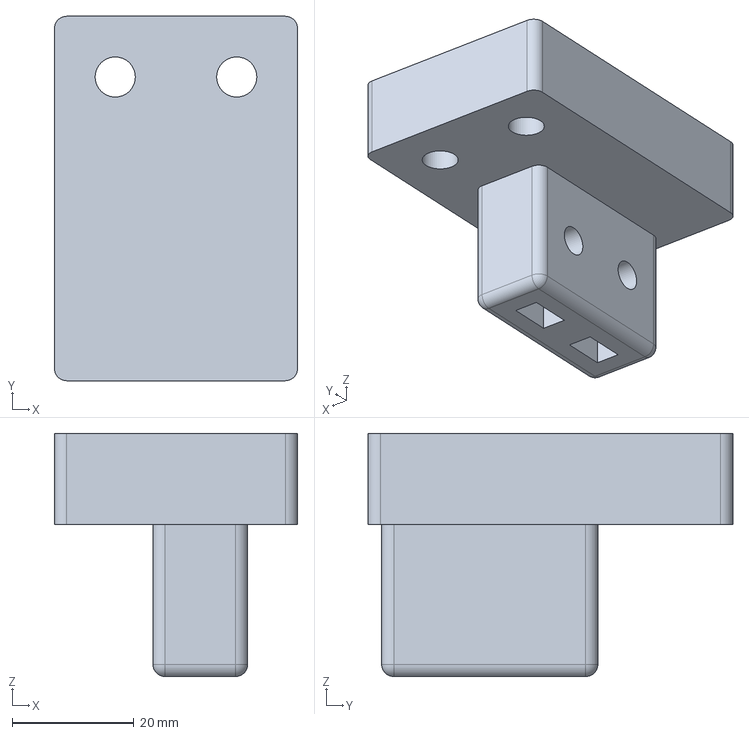
[picture p61: CAD file, 2026-11-12]
cad/energiekette/ek_stuetzen_kopf.step
40.0 x 60.0 x 40.0 mm
