TobiasRosini/cnc_plasmacutter/cad/energiekette/ekx_umlenkkopf.step

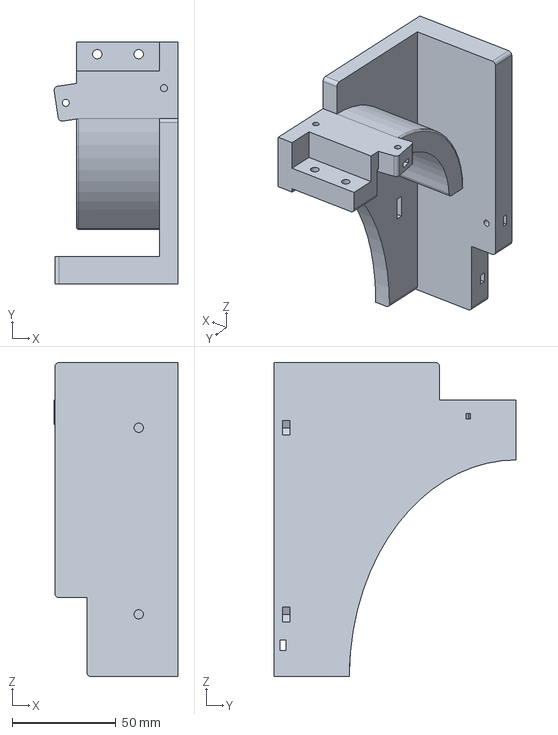
[picture p62: CAD file, 2026-11-12]
cad/energiekette/ekx_umlenkkopf.step
59.7 x 117.0 x 151.5 mm
