TobiasRosini/cnc_plasmacutter/cad/energiekette/ek_einsteckteil.step

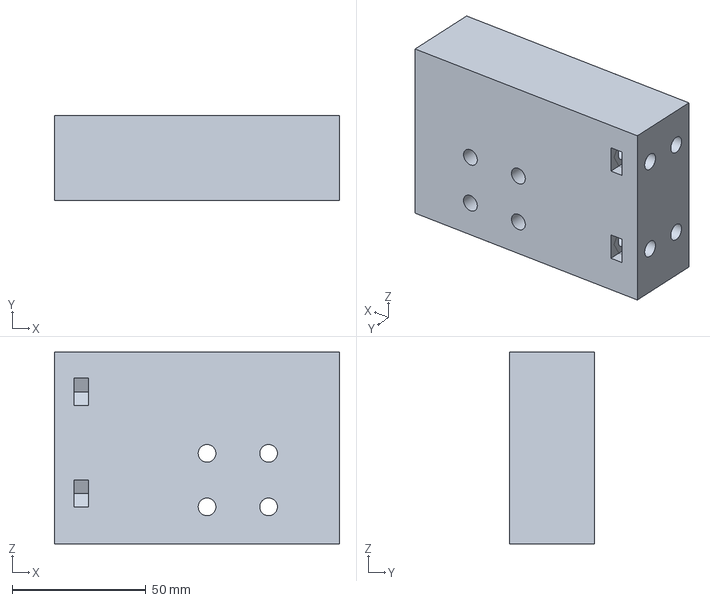
[picture p63: CAD file, 2026-11-12]
cad/energiekette/ek_einsteckteil.step
106.5 x 31.6 x 71.6 mm
