TobiasRosini/cnc_plasmacutter/cad/energiekette/ek_halter_y.step

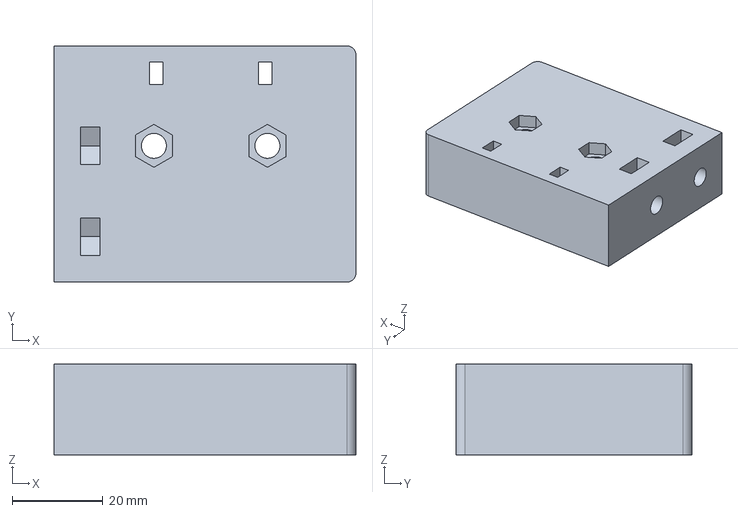
[picture p64: CAD file, 2026-11-12]
cad/energiekette/ek_halter_y.step
66.5 x 52.0 x 20.0 mm
