TobiasRosini/cnc_plasmacutter/cad/energiekette/ek_leitungsbogen.step

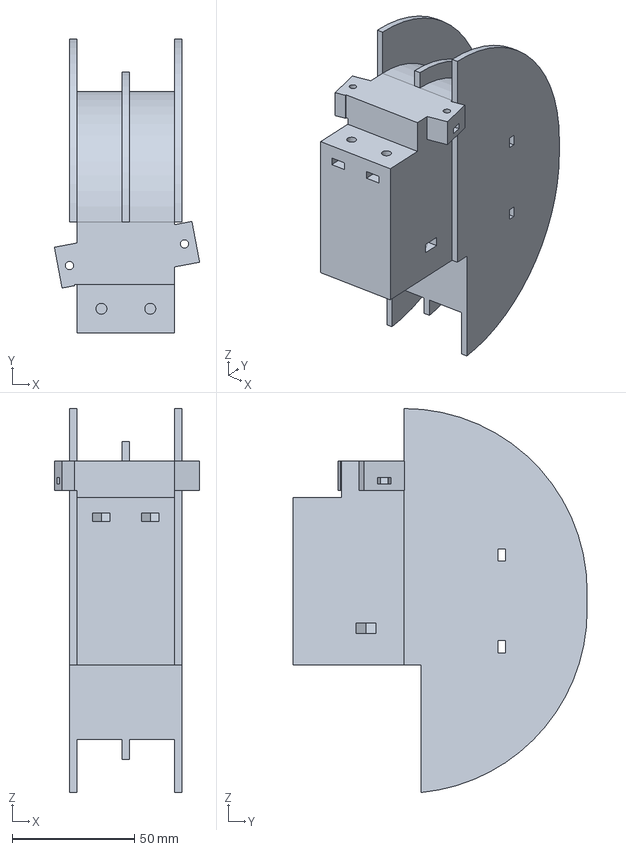
[picture p65: CAD file, 2026-11-09]
cad/energiekette/ek_leitungsbogen.step
59.5 x 120.5 x 157.2 mm
