TobiasRosini/cnc_plasmacutter/cad/energiekette/ekx_pfosten.step

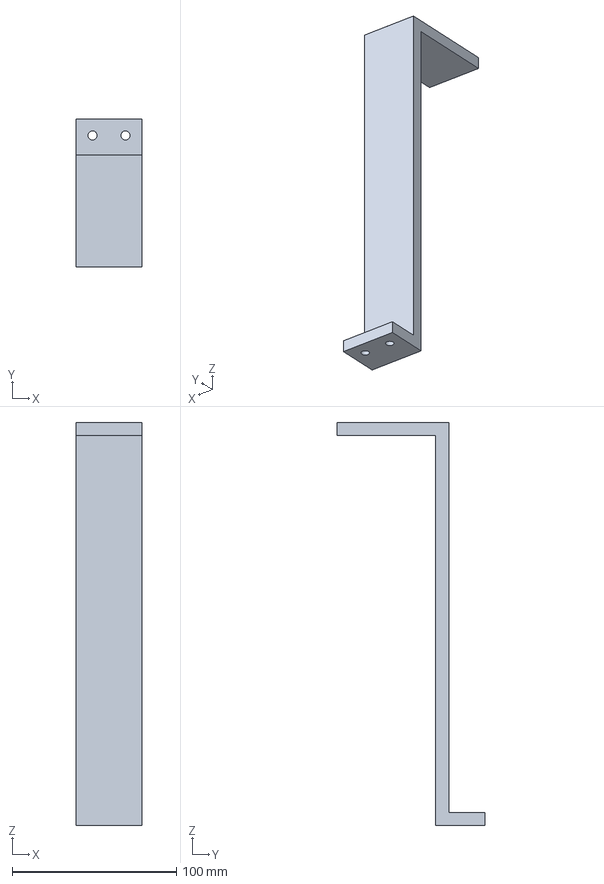
[picture p66: CAD file, 2026-10-24]
cad/energiekette/ekx_pfosten.step
40.0 x 90.0 x 245.0 mm
