TobiasRosini/cnc_plasmacutter/(list of files, cad)

Other CAD files:
cad/y_antrieb/y_motorhalter_l.step
cad/y_antrieb/y_umlenkhalter_l.step
cad/y_antrieb/y_umlenkhalter_r.step
cad/y_antrieb/y_motorhalter_r.step
cad/energiekette/ek_einsteckteil_rechts.step
cad/energiekette/ek_einsteckteil.stl
cad/energiekette/ek_einsteckteil_links.stl
cad/energiekette/ek_einsteckteil_rechts.stl
cad/energiekette/ek_halter_y.stl
cad/energiekette/ek_leitungsbogen_a.stl
cad/energiekette/ek_leitungsbogen_b.stl
cad/energiekette/ek_leitungsbogen_steg.stl
cad/energiekette/ek_leitungsschelle.stl
cad/energiekette/ek_stuetzen_kopf.stl
cad/energiekette/ek_verbindungsplatte.stl
cad/energiekette/ekx_ablagehalter.stl
cad/energiekette/ekx_distanzstueck.stl
cad/energiekette/ekx_halter.stl
cad/energiekette/ekx_leitungssockel.stl
cad/energiekette/ekx_mastwinkel.stl
cad/energiekette/ekx_rinnenhalter.stl
cad/energiekette/ekx_schelle_einseitig.stl
cad/energiekette/ekx_stopfen.stl
cad/energiekette/ekx_umlenkkopf.stl
cad/grundrahmen/grundrahmen.FCStd
cad/unterbau/ub_kanalknoten.stl
cad/unterbau/ub_uebergang_unten.stl
cad/unterbau/ub_uebergang_unten_deckel.stl
cad/wanne/wanne.FCStd
cad/wannenkaefig/wannenkaefig.FCStd
cad/x_wagen/x_motorbock.stl
cad/x_wagen/x_wagenkoerper.stl
cad/y_antrieb/y_motorhalter.stl
cad/y_antrieb/y_motorhalter_l.stl
cad/y_antrieb/y_motorhalter_r.stl
cad/y_antrieb/y_umlenkhalter.stl
cad/y_antrieb/y_umlenkhalter_l.stl
cad/y_antrieb/y_umlenkhalter_r.stl
cad/y_portalwinkel/klemmplatte_fest.stl
cad/y_portalwinkel/klemmplatte_schlitten.stl
cad/y_portalwinkel/spannschlitten.stl
cad/y_portalwinkel/winkel_fest.stl
cad/y_portalwinkel/winkel_kasten.stl
cad/y_portalwinkel/x_klemmplatte.stl
cad/z_achse/z_halter.stl
cad/z_achse/z_halter_oben.stl
cad/z_achse/z_klemmdeckel.stl
cad/z_achse/z_kopf.stl
cad/z_achse/z_motorhalter.stl
cad/z_achse/z_mutterblock.stl
cad/z_achse/z_traeger.stl
