TobiasRosini/cnc_plasmacutter/cad/zusammenbau/montage.txt

Bohrungen ohne Gegenstück im Nachbarteil: 0 offen, 62 gewollt
Bohrungen, die sich im selben Teil schneiden: 0
gewollt P_links_Flachstange_40x15 -> P_links_winkel_fest (Ø8.0 bei 687.0, 710.0, 889.2): Senkung der Wagenschraube, wird vom Winkel überdeckt (erst Flachstange montieren)
gewollt P_links_Flachstange_40x15 -> P_links_winkel_fest (Ø8.0 bei 687.0, 736.0, 889.2): Senkung der Wagenschraube, wird vom Winkel überdeckt (erst Flachstange montieren)
gewollt P_links_Flachstange_40x15 -> P_links_winkel_fest (Ø8.0 bei 687.0, 820.0, 889.2): Senkung der Wagenschraube, wird vom Winkel überdeckt (erst Flachstange montieren)
gewollt P_links_Flachstange_40x15 -> P_links_winkel_fest (Ø8.0 bei 687.0, 846.0, 889.2): Senkung der Wagenschraube, wird vom Winkel überdeckt (erst Flachstange montieren)
gewollt P_links_Flachstange_40x15 -> P_links_winkel_fest (Ø8.0 bei 713.0, 710.0, 889.2): Senkung der Wagenschraube, wird vom Winkel überdeckt (erst Flachstange montieren)
gewollt P_links_Flachstange_40x15 -> P_links_winkel_fest (Ø8.0 bei 713.0, 736.0, 889.2): Senkung der Wagenschraube, wird vom Winkel überdeckt (erst Flachstange montieren)
gewollt P_links_Flachstange_40x15 -> P_links_winkel_fest (Ø8.0 bei 713.0, 820.0, 889.2): Senkung der Wagenschraube, wird vom Winkel überdeckt (erst Flachstange montieren)
gewollt P_links_Flachstange_40x15 -> P_links_winkel_fest (Ø8.0 bei 713.0, 846.0, 889.2): Senkung der Wagenschraube, wird vom Winkel überdeckt (erst Flachstange montieren)
gewollt P_links_spannschlitten -> P_links_winkel_fest (Ø3.4 bei 687.5, 839.2, 933.8): Muttertasche/Schraube endet im Schlitten
gewollt P_links_spannschlitten -> P_links_winkel_fest (Ø3.4 bei 687.5, 849.2, 933.8): Muttertasche/Schraube endet im Schlitten
gewollt P_links_spannschlitten -> P_links_winkel_fest (Ø3.4 bei 712.5, 839.2, 933.8): Muttertasche/Schraube endet im Schlitten
gewollt P_links_spannschlitten -> P_links_winkel_fest (Ø3.4 bei 712.5, 849.2, 933.8): Muttertasche/Schraube endet im Schlitten
gewollt P_links_winkel_fest -> Portalbruecke_80x40x4 (Ø3.4 bei 685.0, 751.5, 955.0): M3 der X-Riemenklemme endet in der Mutter innen an der Sattelrückwand (Schraube nicht länger als Klemmplatte + Wand)
gewollt P_links_winkel_fest -> Portalbruecke_80x40x4 (Ø3.4 bei 685.0, 751.5, 981.0): M3 der X-Riemenklemme endet in der Mutter innen an der Sattelrückwand (Schraube nicht länger als Klemmplatte + Wand)
gewollt P_links_winkel_fest -> Portalbruecke_80x40x4 (Ø7.5 bei 686.8, 768.0, 905.0): Senkschraube M4 im Sattelboden, liegt unter der Brücke (vor der Brücke montieren)
gewollt P_links_winkel_fest -> Portalbruecke_80x40x4 (Ø7.5 bei 686.8, 788.0, 905.0): Senkschraube M4 im Sattelboden, liegt unter der Brücke (vor der Brücke montieren)
gewollt P_links_winkel_fest -> Portalbruecke_80x40x4 (Ø7.5 bei 713.2, 768.0, 905.0): Senkschraube M4 im Sattelboden, liegt unter der Brücke (vor der Brücke montieren)
gewollt P_links_winkel_fest -> Portalbruecke_80x40x4 (Ø7.5 bei 713.2, 788.0, 905.0): Senkschraube M4 im Sattelboden, liegt unter der Brücke (vor der Brücke montieren)
gewollt P_links_winkel_fest -> Portalbruecke_80x40x4 (Ø3.4 bei 715.0, 751.5, 955.0): M3 der X-Riemenklemme endet in der Mutter innen an der Sattelrückwand (Schraube nicht länger als Klemmplatte + Wand)
gewollt P_links_winkel_fest -> Portalbruecke_80x40x4 (Ø3.4 bei 715.0, 751.5, 981.0): M3 der X-Riemenklemme endet in der Mutter innen an der Sattelrückwand (Schraube nicht länger als Klemmplatte + Wand)
gewollt P_rechts_Flachstange_40x15 -> P_rechts_winkel_kasten (Ø8.0 bei 7.0, 710.0, 889.2): Senkung der Wagenschraube, wird vom Winkel überdeckt (erst Flachstange montieren)
gewollt P_rechts_Flachstange_40x15 -> P_rechts_winkel_kasten (Ø8.0 bei 7.0, 736.0, 889.2): Senkung der Wagenschraube, wird vom Winkel überdeckt (erst Flachstange montieren)
gewollt P_rechts_Flachstange_40x15 -> P_rechts_winkel_kasten (Ø8.0 bei 7.0, 820.0, 889.2): Senkung der Wagenschraube, wird vom Winkel überdeckt (erst Flachstange montieren)
gewollt P_rechts_Flachstange_40x15 -> P_rechts_winkel_kasten (Ø8.0 bei 7.0, 846.0, 889.2): Senkung der Wagenschraube, wird vom Winkel überdeckt (erst Flachstange montieren)
gewollt P_rechts_Flachstange_40x15 -> P_rechts_winkel_kasten (Ø8.0 bei 33.0, 710.0, 889.2): Senkung der Wagenschraube, wird vom Winkel überdeckt (erst Flachstange montieren)
gewollt P_rechts_Flachstange_40x15 -> P_rechts_winkel_kasten (Ø8.0 bei 33.0, 736.0, 889.2): Senkung der Wagenschraube, wird vom Winkel überdeckt (erst Flachstange montieren)
gewollt P_rechts_Flachstange_40x15 -> P_rechts_winkel_kasten (Ø8.0 bei 33.0, 820.0, 889.2): Senkung der Wagenschraube, wird vom Winkel überdeckt (erst Flachstange montieren)
gewollt P_rechts_Flachstange_40x15 -> P_rechts_winkel_kasten (Ø8.0 bei 33.0, 846.0, 889.2): Senkung der Wagenschraube, wird vom Winkel überdeckt (erst Flachstange montieren)
gewollt P_rechts_spannschlitten -> P_rechts_winkel_kasten (Ø3.4 bei 7.5, 839.2, 933.8): Muttertasche/Schraube endet im Schlitten
gewollt P_rechts_spannschlitten -> P_rechts_winkel_kasten (Ø3.4 bei 7.5, 849.2, 933.8): Muttertasche/Schraube endet im Schlitten
gewollt P_rechts_spannschlitten -> P_rechts_winkel_kasten (Ø3.4 bei 32.5, 839.2, 933.8): Muttertasche/Schraube endet im Schlitten
gewollt P_rechts_spannschlitten -> P_rechts_winkel_kasten (Ø3.4 bei 32.5, 849.2, 933.8): Muttertasche/Schraube endet im Schlitten
gewollt P_rechts_winkel_kasten -> P_rechts_Referenzschalter_X (Ø12.1 bei 30.0, 753.2, 1001.0): Bohrung für den Schalter (Schalter steckt darin)
gewollt P_rechts_winkel_kasten -> Portalbruecke_80x40x4 (Ø3.4 bei 5.0, 751.5, 955.0): M3 der X-Riemenklemme endet in der Mutter innen an der Sattelrückwand (Schraube nicht länger als Klemmplatte + Wand)
gewollt P_rechts_winkel_kasten -> Portalbruecke_80x40x4 (Ø3.4 bei 5.0, 751.5, 981.0): M3 der X-Riemenklemme endet in der Mutter innen an der Sattelrückwand (Schraube nicht länger als Klemmplatte + Wand)
gewollt P_rechts_winkel_kasten -> Portalbruecke_80x40x4 (Ø7.5 bei 6.8, 768.0, 905.0): Senkschraube M4 im Sattelboden, liegt unter der Brücke (vor der Brücke montieren)
gewollt P_rechts_winkel_kasten -> Portalbruecke_80x40x4 (Ø7.5 bei 6.8, 788.0, 905.0): Senkschraube M4 im Sattelboden, liegt unter der Brücke (vor der Brücke montieren)
gewollt P_rechts_winkel_kasten -> Portalbruecke_80x40x4 (Ø7.5 bei 33.2, 768.0, 905.0): Senkschraube M4 im Sattelboden, liegt unter der Brücke (vor der Brücke montieren)
gewollt P_rechts_winkel_kasten -> Portalbruecke_80x40x4 (Ø7.5 bei 33.2, 788.0, 905.0): Senkschraube M4 im Sattelboden, liegt unter der Brücke (vor der Brücke montieren)
gewollt P_rechts_winkel_kasten -> Portalbruecke_80x40x4 (Ø3.4 bei 35.0, 751.5, 955.0): M3 der X-Riemenklemme endet in der Mutter innen an der Sattelrückwand (Schraube nicht länger als Klemmplatte + Wand)
gewollt P_rechts_winkel_kasten -> Portalbruecke_80x40x4 (Ø3.4 bei 35.0, 751.5, 981.0): M3 der X-Riemenklemme endet in der Mutter innen an der Sattelrückwand (Schraube nicht länger als Klemmplatte + Wand)
gewollt X_x_motorbock -> X_Motor_X_NEMA23 (Ø5.5 bei 336.4, 663.5, 992.7): Langloch zum Spannen: der Motor wird darin verschoben
gewollt X_x_motorbock -> X_Motor_X_NEMA23 (Ø5.5 bei 336.4, 671.5, 992.7): Langloch zum Spannen: der Motor wird darin verschoben
gewollt X_x_motorbock -> X_Motor_X_NEMA23 (Ø5.5 bei 336.4, 710.7, 992.7): Langloch zum Spannen: der Motor wird darin verschoben
gewollt X_x_motorbock -> X_Motor_X_NEMA23 (Ø5.5 bei 336.4, 718.7, 992.7): Langloch zum Spannen: der Motor wird darin verschoben
gewollt X_x_motorbock -> X_Motor_X_NEMA23 (Ø5.5 bei 383.6, 663.5, 992.7): Langloch zum Spannen: der Motor wird darin verschoben
gewollt X_x_motorbock -> X_Motor_X_NEMA23 (Ø5.5 bei 383.6, 671.5, 992.7): Langloch zum Spannen: der Motor wird darin verschoben
gewollt X_x_motorbock -> X_Motor_X_NEMA23 (Ø5.5 bei 383.6, 710.7, 992.7): Langloch zum Spannen: der Motor wird darin verschoben
gewollt X_x_motorbock -> X_Motor_X_NEMA23 (Ø5.5 bei 383.6, 718.7, 992.7): Langloch zum Spannen: der Motor wird darin verschoben
gewollt Y_hl_y_motorhalter -> Y_hl_Referenzschalter_Y (Ø12.2 bei 700.0, 48.0, 948.0): Bohrung für den Schalter (Schalter steckt darin)
gewollt Y_hr_y_motorhalter -> Y_hr_Referenzschalter_Y (Ø12.2 bei 20.0, 48.0, 948.0): Bohrung für den Schalter (Schalter steckt darin)
gewollt Z_z_halter -> Z_z_traeger (Ø9.5 bei 346.0, 889.2, 989.0): Schraubenkopf in der Rückenplatte, vom Brennerträger überdeckt (Halter vor dem Träger montieren)
gewollt Z_z_halter -> Z_z_traeger (Ø8.5 bei 348.0, 889.0, 1019.0): Schraubenkopf in der Rückenplatte, vom Brennerträger überdeckt (Halter vor dem Träger montieren)
gewollt Z_z_halter -> Z_z_traeger (Ø8.5 bei 348.0, 889.0, 1043.0): Schraubenkopf in der Rückenplatte, vom Brennerträger überdeckt (Halter vor dem Träger montieren)
gewollt Z_z_halter -> Z_z_traeger (Ø9.5 bei 360.0, 889.2, 1035.0): Schraubenkopf in der Rückenplatte, vom Brennerträger überdeckt (Halter vor dem Träger montieren)
gewollt Z_z_halter -> Z_z_traeger (Ø8.5 bei 372.0, 889.0, 1019.0): Schraubenkopf in der Rückenplatte, vom Brennerträger überdeckt (Halter vor dem Träger montieren)
gewollt Z_z_halter -> Z_z_traeger (Ø8.5 bei 372.0, 889.0, 1043.0): Schraubenkopf in der Rückenplatte, vom Brennerträger überdeckt (Halter vor dem Träger montieren)
gewollt Z_z_halter -> Z_z_traeger (Ø9.5 bei 374.0, 889.2, 989.0): Schraubenkopf in der Rückenplatte, vom Brennerträger überdeckt (Halter vor dem Träger montieren)
gewollt Z_z_halter_oben -> Z_Schalter_Schwimmkopf (Ø12.2 bei 385.0, 929.0, 1062.2): Bohrung für den Schalter (Schalter steckt darin)
gewollt Z_z_kopf -> Z_Referenzschalter (Ø12.2 bei 406.0, 874.0, 1187.0): Bohrung für den Schalter (Schalter steckt darin)
gewollt Z_z_traeger -> Z_Stäbe_D8 (Ø5.0 bei 319.6, 901.0, 1017.0): Schmierkanal des Nippels M6, endet an der Welle (gewollt)
gewollt Z_z_traeger -> Z_Stäbe_D8 (Ø5.0 bei 400.4, 901.0, 1017.0): Schmierkanal des Nippels M6, endet an der Welle (gewollt)
