TobiasRosini/cnc_plasmacutter/(commit log)

2026-10-19 Projektstruktur anlegen: docs, cad, linuxcnc, elektrik
2026-10-19 Doku: Achszuordnung, Portalbrücke, Y-Lagerung und Fertigungsmöglichkeiten
2026-10-19 CAD: Y-Portalwinkel (Brücke an HGH15-Wagen) parametrisch in FreeCAD
    - Alu-Flachstange 40x15 mit gesenkten M4-Bohrungen für 2x HGH15CA und
    1:1-Bohrschablone
    - 3D-gedruckter Winkel mit Sattel für die Brücke 20x40x4 (hochkant)
    - Riemenbefestigung HTD5M/15: eingeprägtes Zahnprofil am festen Ende,
    nach außen offene Schwalbenschwanznut mit Spannschlitten und
    Spannschraube auf Zug am anderen Ende
    - Befestigungsflansch für die Energiekette
    - Doku: Riemen auf HTD5M/15 korrigiert
    [flachstange_40x15.step, klemmplatte_fest.step, klemmplatte_fest.stl, klemmplatte_schlitten.step, klemmplatte_schlitten.stl, spannschlitten.step, spannschlitten.stl, winkel_druckteil.step]
2026-10-20 CAD: Grundrahmen 40x40x3 (erster Entwurf), Randbedingungen erfasst
    - Parametrischer FreeCAD-Rahmen ohne Gehrungen, Längsträger mit
    M4-Gewinden für HGR15, Unterrahmen mit Auflage für den Wannenträger,
    Zuschnittliste und Prüfung
    - Doku: max. Gesamtbreite 800 mm (Tür 820), Einstellfüße und Rollen
    [grundrahmen.FCStd, grundrahmen.step]
2026-10-20 CAD: Wanne, Zusammenbau und Live-Ablauf im offenen FreeCAD
    - Wanne nach Aufmaß (597x1194x119, Bördel, R13-Ecken, Wasserinhalt)
    - Zusammenbau aus Verknüpfungen auf Rahmen, Wanne und Portalwinkel,
    Portalbrücke in voller Länge, Prüfung von Gesamtbreite und Y-Hub
    - cad/live.py führt die Skripte im laufenden FreeCAD aus (RPC des
    MCP-Addons), sonst headless; cad/fc_dok.py aktualisiert Objekte über
    ihren Namen, setzt Farben und Sichtbarkeit
    - Doku: Verfahrbereich 1100x550, Wannenaufmaß
    [flachstange_40x15.step, grundrahmen.FCStd, grundrahmen.step, klemmplatte_fest.step, klemmplatte_schlitten.step, spannschlitten.step, wanne.FCStd, wanne.step]
2026-10-21 CAD: X-Achse (Omega), Y-Antrieb, Z-Achse, Wannenkäfig, Prüfungen
    - Brücke 80x40x4; Y-Winkel als fest/kasten-Variante mit Riemen über der
    Schiene und X-Riemenklemme hinten
    - X-Wagen mit Omega-Antrieb und Motorbock, Z-Achse mit SFU1204 und
    Schwimmkopf, Y-Motoren hinten innen mit Umlenkung vorn
    - Wannenkäfig 20x20x2, Rahmen verlängert (Brennerversatz), Kaufteile
    (NEMA23, HTD5M-Scheibe, HGR15/HGH15, SFU1204, FK10, Brenner)
    - Prüfungen: Kollisionen in allen Endlagen, Wandstärke an Bohrungen,
    Gesamtbreite; Farbkonzept
    - Doku: Fahrwerte, Motoren, Wasserstand, Wannenkäfig
    [flachstange_40x15.step, grundrahmen.FCStd, grundrahmen.step, klemmplatte_fest.step, klemmplatte_fest.stl, klemmplatte_schlitten.step, klemmplatte_schlitten.stl, spannschlitten.step]
2026-10-23 CAD: Referenzschalter, Y-Energiekette, Wannenkäfig-Ablauf, Anleitungen
    - Induktive Referenzschalter LJ12A3-4-Z/AY: Y über den Riemenscheiben
    (Fahne auf der Klemmplatte), X am linken Winkel (Fahne unter der
    Deckplatte), Z im Z-Kopf (Fahne auf dem Schlitten)
    - Y-Energiekette 20x38 R125 liegend links auf Träger mit Rinne,
    Ausleger am linken Winkel; Kette im Zusammenbau je Portallage
    - Z-Kopf links schmaler, Ablauf Ø32, Kaufteil Näherungsschalter
    - Doku: Schalter, Kette, Wanne nach oben heraus; SPARTUS-Anleitungen
    [ek_ausleger.step, ek_rinne.step, energiekette.FCStd, flachstange_40x15.step, grundrahmen.step, klemmplatte_fest.step, klemmplatte_schlitten.step, spannschlitten.step]
2026-10-23 CAD: Kettenturm an der Brücke, X-Energiekette R65
    - Brücke links um 47 mm verlängert; Einsteckteil (Druck) wird mit den
    M6 des Sattels gehalten und trägt den Kettenturm (4x M6)
    - X-Kette 20x38 R65 liegend hinter der Brücke auf eigener Ablage
    (links am Kettenturm, rechts Stütze am rechten Winkel), bewegtes Ende
    am Pfosten auf der Deckplatte; Z ohne Kette
    - Kettenlasche am linken Winkel entfallen, Einsätze für die Stütze
    - Doku: Energieketten, Gesamtbreite 789 mm
    [ek_ausleger.step, ek_einsteckteil.step, ek_einsteckteil.stl, ek_rinne.step, ekx_pfosten.step, energiekette.FCStd, flachstange_40x15.step, klemmplatte_fest.step]
2026-10-24 CAD: Untertisch/Oberrahmen, Montageprüfung, Ketten und Motoren überarbeitet
    - Rahmen in zwei verschraubte Baugruppen (Untertisch mit Wannenkäfig,
    Oberrahmen mit Schienen), 6x M8
    - Montageprüfung (pruefe_montage.py, MONTAGE.md): fehlende Bohrungen und
    Gewinde ergänzt (Brücke, Oberrahmen, Kettenträger, X-Ablage)
    - Y-Kette mit Schlaufe hinten (Kabel nach vorn), X-Ablage über der Brücke
    an beiden Brückenstirnen, bewegtes Ende am Z-Kopf; Kettenendstücke
    - Z-Kopf geteilt in Sockel und Motorhalter
    - Y-Motoren 1,9 Nm statt 3 Nm, Motor mit sichtbaren Befestigungsbohrungen
    - Speichern abgesichert (FreeCAD schrieb teils nicht)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
    [ek_ausleger.step, ek_einsteckteil.step, ek_einsteckteil.stl, ek_rinne.step, ekx_halter.step, ekx_pfosten.step, energiekette.FCStd, flachstange_40x15.step]
2026-10-24 CAD: Kettenturm als gerades Flachmaterial, Druckteile für Kettenenden und Leitungsweg
    - Kettenturm ohne Laschen und obere Platte, 40 tief
    - Halter Y (bewegtes Y-Ende), Festhalter X (festes X-Ende + Zapfen für die
    X-Ablage, gleicht den Versatz aus), zwei Leitungsclips, Leitungsbündel
    - ekx_halter als Druckteil mit Bogenkanal nach oben, Strebe, M4 für Tülle
    - rechte Platte 40 tief, linker Stopfen entfällt
    [ek_ausleger.step, ek_einsteckteil.step, ek_einsteckteil_rechts.step, ek_einsteckteil_rechts.stl, ek_halter_y.step, ek_halter_y.stl, ek_leitungsclips.step, ek_leitungsclips.stl]
2026-10-24 CAD: X-Wagenkörper als Druckteil, Motorbock geflanscht, Muttern statt Einsätze, Rahmen auf Nietmuttern
    - X-Wagen: Deck/Front/Boden als ein Druckteil (60 breit), Z-Grundplatte bis unten,
    Spritzschutz, Ref-Stift statt Fahne; Motorbock von hinten angeflanscht, Stege,
    Spannen über den Motor in Langlöchern, Umlenkrollen auf festen Achsen
    - ekx_halter als Druckteil mit Bogenkanal, Strebe und Gewinden für eine Tülle
    - Druckteile: eingepresste Muttern (fc_dok.mutter) statt Gewindeeinsätze
    - Rahmen: Oberrahmen/Untertisch und Wannenkäfig in Nietmuttern statt langer
    Bolzen (Käfigbohrungen lagen 10 mm versetzt), Y-Kettenstütze als ein Rohr mit
    Druckkopf; rechte Einsteckteil-Löcher sch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
    [ek_ausleger.step, ek_einsteckteil.step, ek_einsteckteil.stl, ek_einsteckteil_rechts.step, ek_einsteckteil_rechts.stl, ek_halter_y.step, ek_halter_y.stl, ek_leitungsclips.step]
2026-11-02 CAD: Brenner SP80M aufgemessen, Schwimmkopf vor dem Z-Schlitten mit Klemmschale
    Brenner 510 lang, Spannbereich Verbundrohr Ø35 (135-375 über der Düse).
    Halter mit Rückenplatte und zwei Stegen, Träger mit Klemmdeckel (4x M4)
    klemmt 140-210 über der Düse. Z-Hub unverändert, unter Brücke + 50 nur
    noch der Brenner. Montageprüfung 0 offen.
    [z_achse.FCStd, z_grundplatte.step, z_halter.step, z_halter.stl, z_klemmdeckel.step, z_klemmdeckel.stl, z_kopf.step, z_leisten_20x20.step]
2026-11-03 CAD: Seiten gespiegelt (Y-Kette rechts), Leitungsweg mit Rinne und Ablagehaltern
    - Seitenkonvention von vorn gesehen: Y-Kette/-Antriebsteile rechts, Kettenturm-Platte links
    - Festhalter und Leitungsclips ersetzt durch Ablagehalter, Rinnenhalter und Rinne hinten
    - Leitungen ohne Schutzschlauch, Adern des Brennerpakets lose durch beide Ketten, min. R60
    - Montage, Verbindungen, Prüfungen und Projektstand nachgezogen
    [ek_ausleger.step, ek_einsteckteil.step, ek_einsteckteil_links.step, ek_einsteckteil_links.stl, ek_halter_y.step, ek_halter_y.stl, ek_leitungsclips.step, ek_leitungsclips.stl]
2026-11-03 CAD: Festpunkt der X-Kette in die Mitte des X-Wegs
    - X-Kette 0,53 statt 0,80 m, Leitungen Y-Ende -> X-Festpunkt 1,15 statt 1,42 m
    - Rinne hinten halb so lang, zwei statt drei Rinnenhalter
    - Prüfung meldet die freie Länge des oberen Trums (ca. 283 mm)
    - README, Montage und Projektstand nachgezogen
    [ek_ausleger.step, ek_einsteckteil.step, ek_einsteckteil_links.step, ek_halter_y.step, ek_halter_y.stl, ek_rinne.step, ek_stuetzen_kopf.step, ekx_ablagehalter.step]
2026-11-03 CAD: Energieketten auf igus 2400.03 mit Anschlussteilen 2030.12PZ
    - Y: 2400.03.125.0, 23 Glieder; X: 2400.03.075.0 (R75), 14 Glieder, Längen nach igus S/2 + K
    - Anschlussteile nach igus-Zeichnung (2x Ø6,1 im Abstand 25, 10 mm vom Ende), Halter angepasst
    - Festpunkte folgen aus der Kettenlänge: X bei Rahmen-x 476, Y bei Rahmen-y 825
    - feste Kettenenden mit M5 in Nietmuttern in Y-Träger und X-Ablage, Rinne hinten auf drei Haltern
    - Bestellliste in README und Montage, Projektstand nachgezogen
    [ek_ausleger.step, ek_einsteckteil.step, ek_einsteckteil_links.step, ek_halter_y.step, ek_halter_y.stl, ek_rinne.step, ek_stuetzen_kopf.step, ekx_ablagehalter.step]
2026-11-03 CAD: Unterbau mit Geräteboden, Schaltschrank, Tropfboden und Kabelweg; Kabelliste
    - neue Baugruppe unterbau: Geräteboden (Alu 4, M6 in Nietmuttern im Grundrahmen),
    Plasmagerät vorn rechts, Schaltschrank 400x500x200 vorn links, Tropfboden mit
    Gefälle nach hinten und Hülse für den Wannenablauf, Kabelkanäle senkrecht und quer
    - Y-Rinne endet hinter dem festen Kettenende, davor Kabelkanal 40x40 bis y 1450
    - Zusammenbau: Unterbau eingebunden und in der Portal-Endlagenprüfung
    - Kabelliste mit igus chainflex CF10.07.05 / CF9.02.03.INI, Belegung und Längen
    [ek_ausleger.step, ek_einsteckteil.step, ek_einsteckteil_links.step, ek_halter_y.step, ek_rinne.step, ek_stuetzen_kopf.step, ekx_ablagehalter.step, ekx_halter.step]
2026-11-03 CAD: Spritzschutz für Y-Schienen und untere X-Schiene, Schwimmkopf bleibt
    - Alu-Streifen innen an den Y-Längsträgern (25 über Rahmen-OK, Blindnieten Ø4)
    - Schutzlappen aus Silikon-Glasgewebe vorn unten an der Z-Grundplatte, geklemmt mit
    Alu-Leiste auf den unteren M5; im X-Weg nicht mitgeprüft (weich)
    - Doku: Begründung Schwimmkopf, Spritzschutz-Konzept, Abstreifer an den X-Wagen
    [grundrahmen.FCStd, grundrahmen.step, z_achse.FCStd, z_grundplatte.step, z_halter.step, z_klemmdeckel.step, z_kopf.step, z_lappenleiste.step]
2026-11-03 CAD: fester Spritzschutz für die untere X-Schiene statt Schutzlappen
    - Schutzstreifen Alu 30x3 von Y-Winkel zu Y-Winkel, läuft zwischen Z-Grundplatte und
    Brenner unter dem Z-Schlitten durch; Halter Alu 4 mm an der Stirn der Flachstangen
    (M4 in Gewinde), Streifen mit M4 und Mutter
    - Schutzlappen und Lappenleiste an der Z-Grundplatte entfernt
    - Zusammenbau: vordere Y-Endlage berücksichtigt den Halter (Y-Hub 1118)
    [flachstange_40x15.step, klemmplatte_fest.step, klemmplatte_schlitten.step, spannschlitten.step, winkel_fest.step, winkel_kasten.step, x_klemmplatte.step, y_portalwinkel.FCStd]
2026-11-03 CAD: Werkstückauflage mit Kammträgern, vorderer Querträger 80x40x4 zum Einspannen
    - neue Baugruppe auflage: 3 Kammträger längs (Stahl 3, Schlitze im Raster 25),
    Auflageleisten Flachstahl 50x3 quer (Teilung 50, bei Bedarf dichter)
    - Oberrahmen 1556 lang, vorderer Querträger 80x40x4 flach, 40 mm Überstand für
    Schraubzwingen; Y-Kettenträger und vordere Stütze am neuen Rahmenende
    - Zusammenbau: Auflage eingebunden, X-Weg gegen feste Kettenteile in beiden Y-Endlagen
    [auflage.FCStd, auflageleiste.step, ek_ausleger.step, ek_einsteckteil.step, ek_einsteckteil_links.step, ek_halter_y.step, ek_rinne.step, ek_stuetzen_kopf.step]
2026-11-03 CAD: Leitungsführung am Y-Ende, Befestigung der Kabelkanäle
    - Leitungsbogen (Druck) auf dem Halter Y, Umlenkkopf (Druck) auf Mast an der Rinne
    hinten, Verbindungsplatte (Druck) dazwischen; Leitungsweg mit seitlichem Versatz
    - Kabelkanal auf dem Y-Träger mit M4 in Nietmuttern, senkrechter Kanal und Querkanal
    mit Distanzstücken (Druck) und M5 in Nietmuttern im Rahmen
    [ek_ausleger.step, ek_einsteckteil.step, ek_einsteckteil_links.step, ek_halter_y.step, ek_leitungsbogen.step, ek_leitungsbogen.stl, ek_rinne.step, ek_stuetzen_kopf.step]
2026-11-04 CAD: Halbzeuge vereinheitlicht, Leitungsbügel an der Kettenführung, Ablage hinten statt Rinne
    [auflage.FCStd, auflageleiste.step, ek_ausleger.step, ek_einsteckteil.step, ek_einsteckteil_links.step, ek_halter_y.step, ek_leitungsbogen.step, ek_leitungsbogen.stl]
2026-11-04 CAD: Leitungen zwischen den Ketten in zwei Pfaden (Brenner / Steuerung)
    Trennsteg in Leitungsbogen und Umlenkkopf, fünf gleiche Leitungsschellen
    mit Mittelsteg, Leitungssockel in der Ablage hinten. Versatz oben R70,
    Bündel in der Ablage hinten um 90° verdrillt.
    [ek_ausleger.step, ek_einsteckteil.step, ek_einsteckteil_links.step, ek_halter_y.step, ek_leitungsbogen.step, ek_leitungsbogen.stl, ek_leitungsbuegel_40.step, ek_leitungsbuegel_40.stl]
2026-11-04 CAD: X-Ablage bündig mit Platte und Turm, Rinnenhalter geglättet, Brücke bis an den Turm
    Ablage y -20..20 und oben bündig mit der Platte, X-Kette 3,5 mm nach hinten,
    hinteres M5 des festen X-Kettenendes in den dritten Rinnenhalter. Rinnenhalter
    als L-Profil ohne alte Stufen. Brücke rechts 48,5 mm verlängert (kein Spalt
    zum Kettenturm).
    [ek_ausleger.step, ek_einsteckteil.step, ek_einsteckteil_links.step, ek_halter_y.step, ek_leitungsbogen.step, ek_leitungsbogen.stl, ek_leitungsschelle.step, ek_leitungsschelle.stl]
2026-11-04 CAD: Schwimmkopf-Halter zweiteilig mit eingefangenen Stäben, Schalter LJ12A3, Schmiernippel am Träger
    Halter unten mit Sacklöchern (Stäbe eingepresst), Halter oben mit 2x M5 von
    oben in die Schlitten-Oberkante. Schalter LJ12A3-4-Z/AY im oberen Steg, Ziel
    Zylinderstift 6x10 im Klemmdeckel. Trägerbohrungen zum Aufreiben auf 8,
    Kegelschmiernippel M6 seitlich auf halber Höhe.
    [z_achse.FCStd, z_grundplatte.step, z_halter.step, z_halter.stl, z_halter_oben.step, z_halter_oben.stl, z_klemmdeckel.step, z_klemmdeckel.stl]
2026-11-09 CAD: Zusammenbau in FreeCAD um 180° gedreht (Container Maschine), Skript-Koordinaten unverändert
    [zusammenbau.FCStd]
2026-11-09 CAD: Kabelweg vorn rechts überarbeitet, Kanäle 25 × 60 mit gedruckten Übergängen
    - Plasmagerät 250 mm nach hinten (Platz für Schlauchpaket mit langem Stecker)
    - Geräteboden als Siebdruckplatte 9 mm, vom ersten Mittelquerrohr bis vorn, 6× M6
    - Vordere Y-Kettenstütze 40 × 40 hinter dem Bein, nach unten verlängert, trägt den senkrechten Kanal
    - Senkrechter und Querkanal einheitlich PVC 25 × 60; Querkanal hinter dem Bein in die obere rechte Schrankecke
    - Gedruckte Übergangsteile mit Deckel: Bogen unten, Kopf oben am Y-Träger; Distanzstücke entfallen
    - fc_dok: nur teilweise geladene Dokumente vollständig nachladen (neue Teile fehlten im Zusammenbau)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
    [ek_ausleger.step, ek_einsteckteil.step, ek_einsteckteil_links.step, ek_halter_y.step, ek_leitungsbogen.step, ek_leitungsschelle.step, ek_rinne.step, ek_stuetzen_kopf.step]
2026-11-09 CAD: Kanalknoten vorn rechts statt Kopf oben und vorderem Stützkopf
    - Gedruckter, geschlossener Kanalknoten: Y-Träger und Kanal stecken gemeinsam von hinten
    in einer Muffe (2× M5 von innen), senkrechter Kanal von unten, sitzt auf der Stütze
    (Schürze vorn, 2× M5)
    - Vordere Kettenstütze endet bei z 900, Stützkopf vorn entfällt
    - Y-Träger und Kanal enden bei y 1437 im Knoten
    - Senkrechter Kanal bis z 900, Durchgriffe nur noch für die M6 der Stütze
    [ek_ausleger.step, ek_einsteckteil.step, ek_einsteckteil_links.step, ek_halter_y.step, ek_leitungsbogen.step, ek_leitungsschelle.step, ek_rinne.step, ek_stuetzen_kopf.step]
2026-11-09 CAD: Ablagehalter X auf Platte am Turm gekürzt, X-Ablage und Rinne bis an den Halter verlängert
    [ek_ausleger.step, ek_einsteckteil.step, ek_einsteckteil_links.step, ek_halter_y.step, ek_leitungsbogen.step, ek_leitungsschelle.step, ek_rinne.step, ek_stuetzen_kopf.step]
2026-11-09 CAD: Druckbarkeitsprüfung aller Druckteile (Überhänge > 45°, Brücken)
2026-11-09 CAD: Leitungsbogen und Umlenkkopf dreiteilig (Hälften auf der Wange, Trennsteg als Scheibe), stützenfrei druckbar
    [ek_ausleger.step, ek_einsteckteil.step, ek_einsteckteil_links.step, ek_halter_y.step, ek_leitungsbogen.stl, ek_leitungsbogen_a.step, ek_leitungsbogen_a.stl, ek_leitungsbogen_b.step]
2026-11-12 CAD: Teilenummern für alle Teile (gleiche Teile gleiche Nummer), Stückliste
    [zusammenbau.FCStd]
2026-11-12 CAD: Umlenkkopf aus einem Stück ohne Trennsteg, Leitungsschelle am senkrechten Lauf, Kabelbinder-Schlitze im Mast
    Rückwand oberhalb der Y-Kette nach rechts verbreitert, sechste Leitungsschelle;
    Leitungsbogen bleibt dreiteilig mit Trennsteg. Stückliste nachgeführt.
    [ek_ausleger.step, ek_einsteckteil.step, ek_einsteckteil_links.step, ek_halter_y.step, ek_leitungsbogen_a.step, ek_leitungsbogen_b.step, ek_leitungsbogen_steg.step, ek_leitungsschelle.step]
2026-11-12 CAD: Umlenkkopf unten im Bogen ausgeschnitten, oben bündig mit gekürztem Mast; Distanzstück mit Kabelbindern statt Schlitzen im Mast
    [ek_ausleger.step, ek_einsteckteil.step, ek_einsteckteil_links.step, ek_halter_y.step, ek_leitungsbogen_a.step, ek_leitungsbogen_b.step, ek_leitungsbogen_steg.step, ek_leitungsschelle.step]
2026-11-12 CAD: Versteifungswinkel (Druck) außen an der Ecke Mast / Ablage hinten
    [ek_ausleger.step, ek_einsteckteil.step, ek_einsteckteil_links.step, ek_halter_y.step, ek_leitungsbogen_a.step, ek_leitungsbogen_b.step, ek_leitungsbogen_steg.step, ek_leitungsschelle.step]
2026-11-12 CAD: Schellen mit gerundeten senkrechten Kanten, Verbindungsplatte nach dem Leitungsverlauf, Rinnenhalter mit Fasen, linker bündig mit der Ablage hinten
    [ek_ausleger.step, ek_einsteckteil.step, ek_einsteckteil_links.step, ek_halter_y.step, ek_leitungsbogen_a.step, ek_leitungsbogen_b.step, ek_leitungsbogen_steg.step, ek_leitungsschelle.step]
2026-11-12 CAD: Umlenkkopf mit Zugang zur linken M3 der Schelle am senkrechten Lauf; Montageprüfung 0 offen
    [ek_ausleger.step, ek_einsteckteil.step, ek_einsteckteil_links.step, ek_halter_y.step, ek_leitungsbogen_a.step, ek_leitungsbogen_b.step, ek_leitungsbogen_steg.step, ek_leitungsschelle.step]
2026-11-12 CAD: Spezialschelle am senkrechten Lauf des Umlenkkopfs (rechts verschraubt, links Nippel in Vertiefung der Wange), Wange wieder geschlossen
    [ek_ausleger.step, ek_einsteckteil.step, ek_einsteckteil_links.step, ek_halter_y.step, ek_leitungsbogen_a.step, ek_leitungsbogen_b.step, ek_leitungsbogen_steg.step, ek_leitungsschelle.step]
2026-11-12 CAD: Umlenkkopf unter den Leitungen nur 12-mm-Steg, größerer Ausschnitt, Muttern der Verbindungsplatte von unten eingepresst
    [ek_ausleger.step, ek_einsteckteil.step, ek_einsteckteil_links.step, ek_halter_y.step, ek_leitungsbogen_a.step, ek_leitungsbogen_b.step, ek_leitungsbogen_steg.step, ek_leitungsschelle.step]
2026-11-12 CAD: Radien an allen freien Außenkanten der Druckteile der Energiekette (fc_dok.verrunden)
    Kontaktflächen zu Nachbarteilen, Druckbett-Seite, Bohrungs-, Schlitz- und Taschenränder
    bleiben scharf; Wandstärke an Bohrungen wird je Rundung geprüft. Verbindungsplatte mit
    glattem Rand.
    [ek_ausleger.step, ek_einsteckteil.step, ek_einsteckteil_links.step, ek_halter_y.step, ek_halter_y.stl, ek_leitungsbogen_a.step, ek_leitungsbogen_a.stl, ek_leitungsbogen_b.step]
